Tymur771/bank-transactions-site/cap-box/factory/MFC-box-RevN_drawing.pdf

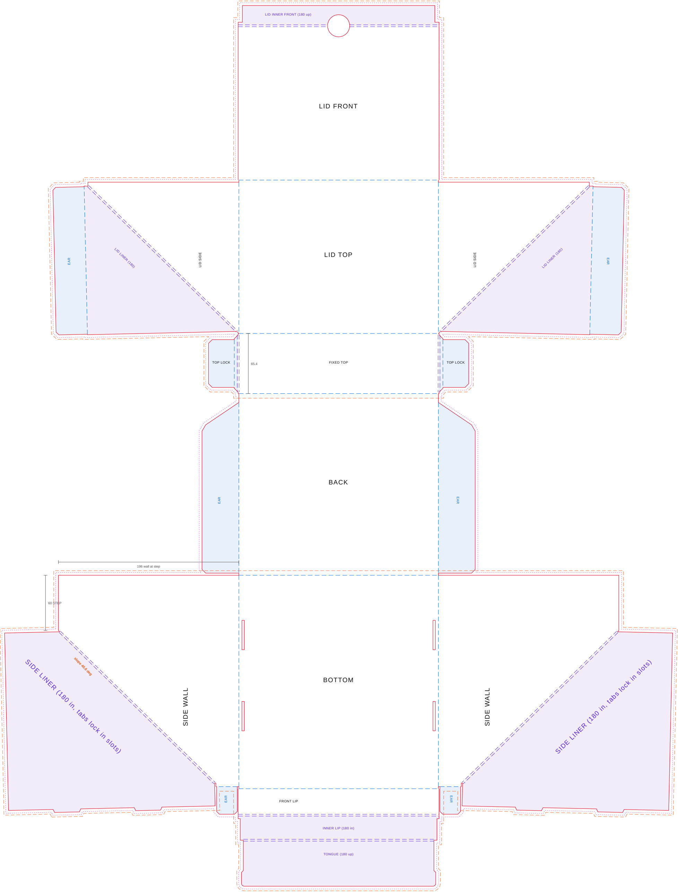
[picture p1: figure]
BOTTOM; FRONT LIP; INNER LIP (180 in); TONGUE (180 up); SID; SIDE LINER (180 in; , tabs lock in slots); SIDE LINER (180 in,; tabs lock in slots); BACK; TOP LOCK; FIXED TOP; LID TOP; LID FRONT; LID INNER FRONT (180 up); LID; LID LINER (180); 60 STEP; 196 wall at step; slope 45.6 deg

22

167.8

166.7

65.4

197.5

232.1

28.8

27.2

957.4 overall

216.7

725.5 overall

# MFC - CAP BOX

Rev N - GLUELESS, STEP 60 mm, LID HINGE AT THE STEP END, 3-LAYER FRONT TONGUE, THUMB NOTCH

Material: E-flute litho-laminated board, caliper ~1.5 mm
Scale 1:1 - units mm - view from OUTSIDE (print side)
All creases fold away from viewer

Closed box (outside approx.): 218.2 W x 233.6 D x 199 H (same as Rev H) Clear inside (between liners): 206 W x 226 D x 196 H (Rev C insert fits) Sheet size: 725.5 x 957.4
Side seam gap: 4.9 mm square to the seam (as Rev H)

CHANGE vs Rev H (orange dashed outline):
10. The side split no longer starts in the back top corner.
Base side wall keeps full height 196 for 60 mm from the back, then slopes 45.6 deg down to the front (front lip unchanged). The base now hides the Rev C insert (top front corner ~53 mm from the back at ~197 mm) when the lid is open.
11. Lid side ends 65.3 mm from the hinge; lid top is cut free over the step. Lid front, lid ears unchanged.
12. Side liners, lid liners and lid ears re-mirrored about the
new 180 fold lines; liner tabs land in the same 4 side slots.
13. Base front height at the seam 26.4 (was 33.6).
14. Rev J: the top is split by a crease 65.3 mm from the back (where the lid side starts). The back part is a FIXED TOP over the step; the lid hinges on that crease, so the lid side turns about its
own tip and stays on the base step when the lid opens.
15. Fixed top has 2 side lock flaps (28 mm) that drop inside the side walls over the step and hold it without glue.
16. Rev K: fixed top at full outside width (as the lid front) with a 180 hem on each side: smooth fold on the corner over the step,
the hem covers the raw top edges of the side walls; the lock
flap drops inside from the hem (hem 4.2 mm, lock 28 mm).
17. Lid front 167.8 mm (was 161.7): it stops 1 mm above the front lip, one clean line at the front; base diagonal ends behind the lip (26.4), so no open notch at the front corner.
18. Rev N: no tuck flap on the lid. The inner lip is plain (no tabs,
no window, the 2 front slots in the bottom are removed). A TONGUE hangs from its bottom edge (double crease) and folds 180 UP behind it: 207 wide up to 33 mm, then 211 wide (close fit between the lid liners = no side play of the lid), 50 mm high, ~22.8 mm above the front lip. Lid front + hem close OUTSIDE over it. Half-round thumb notch R12 on the bottom edge of the lid front (both layers).

NOTES - NO GLUE ANYWHERE (as Rev H)
1. Back and front lip fold up from BOTTOM.
2. Side-wall ears fold in; side walls go up, ears sit BEHIND the front lip. Inner lip folds 180 down over them (no tabs);
then fold the TONGUE 180 UP from the floor so it stands behind it; the insert tray (front edge) holds its bottom fold down.
3. Back ears fold in; side LINER folds 180 over the slope edge,
covers them, 2 tabs push into the bottom slots.
4. Fixed top folds over the step, its 2 lock flaps drop inside the side walls; the lid hinges on the crease at the front edge of the fixed top.
5. Lid front down, lid sides down, lid liners 180 over the slope
edge; their ears go in BEHIND the lid front.
6. Lid inner front folds 180 up and traps those ears;
on closing the lid front + hem go down OUTSIDE the base tongue.
7. Draft for white sample - printer to confirm crease and slot allowances for their board before die.
8. E-flute: run flutes parallel to the long side folds.

Rev N - glueless - generated from Rev H geometry

### LEGEND

Cut (incl. 4 lock slots in bottom, thumb notch) Crease / fold
Double crease 2 mm apart (180 folds) Bleed +3 mm for artwork
Changed vs Rev H

SIDE VIEW, CLOSED (scale 1:2) - front at left

STEP 60

insert

Rev H split
