Tymur771/bank-transactions-site/cap-box/design/MFC-design-directions.html

MFC · The Catch Cap · Rev I

# MFC BOX

Пять направлений дизайна коробки.

Все снимки сделаны на той же 3D-модели по реальной высечке Rev I и вкладышу Rev C. Печать внутри крышки показана как опция с двусторонней печатью. Дно у всех одинаковое: печать, флаг, «Designed in California» и значки.

Stone · v1.1: закрытая коробка

01

## Stone · v1.1

Ваше направление, доведённое до чистовика.

Логотип стал опорой композиции: 40 мм на переде, 110 мм тон-в-тон на крышке, крупно внутри и на задней стенке. Серо-бежевый картон, разреженный Montserrat и курсив Cormorant Garamond для тёплых строк.

- Картон#d8d1c6
- Внутри#dcd6cc
- Текст#4c4640
- Логотип#4a3a2f

ЗакрытаОткрытаВнутри крышкиСзадиДно

Stone · v1.1 — Открыта

Stone · v1.1 — Внутри крышки

Stone · v1.1 — Сзади

Stone · v1.1 — Дно

Noir: закрытая коробка

02

## Noir

Тёмная коробка, светлое нутро.

Матовый эспрессо снаружи, кремовый текст и логотип. При открытии внутри песочный цвет, вкладыш светлый: кепка «подсвечена» контрастом. Большой марлин на крышке почти не виден, проявляется на свету.

- Картон#2b2623
- Внутри#cdbfa8
- Текст#ece3d4

ЗакрытаОткрытаВнутри крышкиСзадиДно

Noir — Открыта

Noir — Внутри крышки

Noir — Сзади

Noir — Дно

Coastline: закрытая коробка

03

## Coastline

Линия горизонта и «the catch».

Белый, как выцветший на солнце, картон и глубокий сланцево-синий. Перед крышки повторяет вышивку кепки: «the catch» курсивом с засечками. Тонкая линия горизонта обходит все стороны на высоте 58 мм и продолжается через диагональный шов.

- Картон#eeeae2
- Внутри#e9e4db
- Текст#2e3a45

ЗакрытаОткрытаВнутри крышкиСзадиДно

Coastline — Открыта

Coastline — Внутри крышки

Coastline — Сзади

Coastline — Дно

Big Mark: закрытая коробка

04

## Big Mark

Логотип больше коробки.

Песочный картон и марлин размером 300 мм, обрезанный краями крышки: хвост и рыба на верхе, рыбак переходит на перед. Текст только по углам. Подход модных домов: знак вместо надписи.

- Картон#cbbda4
- Внутри#ece4d6
- Текст#4b4034

ЗакрытаОткрытаВнутри крышкиСзадиДно

Big Mark — Открыта

Big Mark — Внутри крышки

Big Mark — Сзади

Big Mark — Дно

Sun-faded: закрытая коробка

05

## Sun-faded

Закат по диагонали.

Двухцветная коробка: глиняно-терракотовая крышка и кремовая основа. Диагональный шов становится главным графическим приёмом: сбоку коробка читается как закат над водой. Внутри крышки тот же терракотовый цвет.

- Картон#efe6d6
- Крышка#b8704f
- Текст#8a4a31

ЗакрытаОткрытаВнутри крышкиСзадиДно

Sun-faded — Открыта

Sun-faded — Внутри крышки

Sun-faded — Сзади

Sun-faded — Дно

Нажмите на миниатюру, чтобы открыть её крупно. Для каждого направления есть файлы для печати (PDF, текст в кривых) и редактируемые SVG в cap-box/design/variants/.
