Tymur771/bank-transactions-site/cap-box/print/MFC-box-RevH_design-template.pdf

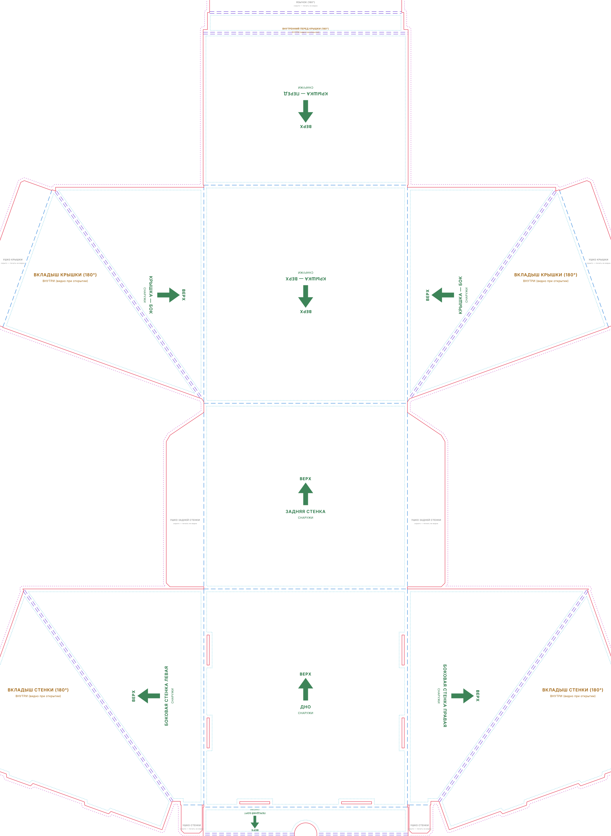
[picture p2: figure]
ВЕРХ; ДНО; СНАРУЖИ; АРУ; ВКЛАДЫШ СТЕНКИ (180°); ВНУТРИ (видно при открытии); УШКО СТЕНКИ; скрыто — печать не видна; С Н АРУ; ЗАДНЯЯ СТЕНКА; УШКО ЗАДНЕЙ СТЕНКИ; ВНУТРЕННИЙ ПЕРЕД КРЫШКИ (180°); ЯЗЫЧОК (180°); ВКЛАДЫШ КРЫШКИ (180°); УШКО КРЫШКИ

ВНУТРЕННИЙ БОРТ (180°)

ВНУТРИ (видно при открытии)

## MFC — CAP BOX · Rev H · шаблон для дизайна (вид с лицевой стороны, 1:1, мм)

Артборд 754.12 × 973.62 мм. Рисуйте в слое ARTWORK, фон тяните до пунктира BLEED (+3 мм).
Текст и логотипы — внутри голубой SAFE-зоны (3 мм от высечки и биговки). Стрелка ВЕРХ = верх на собранной коробке.
Слои CUT / CREASE / SAFE / BLEED / подсказки — технические, перед печатью скрыть (высечку даёт фабрика).
