Tymur771/bank-transactions-site/cap-box/print/MFC-box-RevI_design-template.pdf

## MFC — CAP BOX · Rev I (уступ 60 мм) · шаблон для дизайна (вид с лицевой стороны, 1:1, мм)

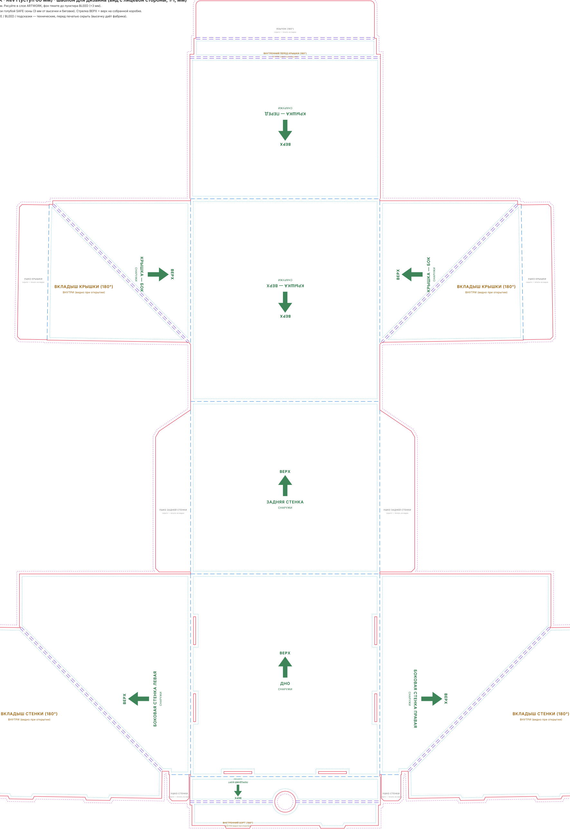
[picture p3: figure]
ВЕРХ; ДНО; СНАРУЖИ; ВНУТРЕННИЙ БОРТ (180°); ВНУТРИ (видно при открытии); АРУ; ВКЛАДЫШ СТЕНКИ (180°); УШКО СТЕНКИ; скрыто — печать не видна; С Н АРУ; ЗАДНЯЯ СТЕНКА; УШКО ЗАДНЕЙ СТЕНКИ; ВНУТРЕННИЙ ПЕРЕД КРЫШКИ (180°); ЯЗЫЧОК (180°); ВКЛАДЫШ КРЫШКИ (180°); УШКО КРЫШКИ

Артборд 757.73 × 973.6 мм. Рисуйте в слое ARTWORK, фон тяните до пунктира BLEED (+3 мм).
Текст и логотипы — внутри голубой SAFE-зоны (3 мм от высечки и биговки). Стрелка ВЕРХ = верх на собранной коробке.
Слои CUT / CREASE / SAFE / BLEED / подсказки — технические, перед печатью скрыть (высечку даёт фабрика).
