Tymur771/bank-transactions-site/cap-box/print/MFC-box-RevK_design-template.pdf

MFC — CAP BOX · Rev K (уступ 60 мм, петля на конце уступа, чистые углы) · шаблон для дизайна (1:1, мм)

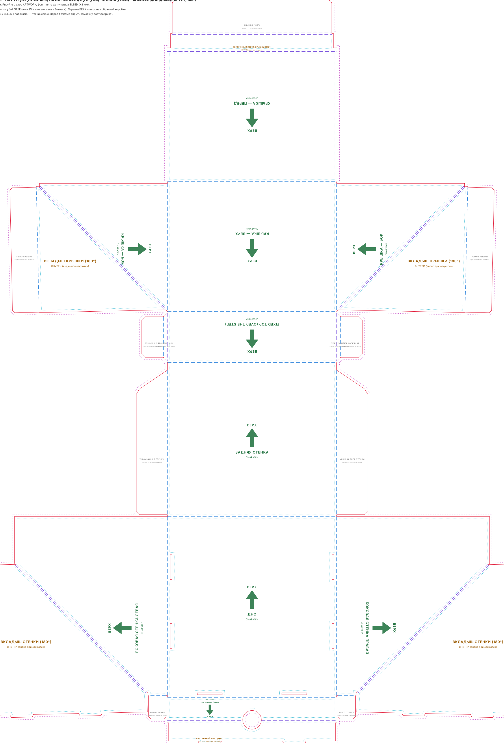
[picture p4: figure]
ВЕРХ; ДНО; СНАРУЖИ; ВНУТРЕННИЙ БОРТ (180°); ВНУТРИ (видно при открытии); АРУ; ВКЛАДЫШ СТЕНКИ (180°); УШКО СТЕНКИ; скрыто — печать не видна; С Н АРУ; ЗАДНЯЯ СТЕНКА; УШКО ЗАДНЕЙ СТЕНКИ; TOP HEM (180); TOP LOCK FLAP; ВНУТРЕННИЙ ПЕРЕД КРЫШКИ (180°); ЯЗЫЧОК (180°); ВКЛАДЫШ КРЫШКИ (180°); УШКО КРЫШКИ

Артборд 751.61 × 979.7 мм. Рисуйте в слое ARTWORK, фон тяните до пунктира BLEED (+3 мм).
Текст и логотипы — внутри голубой SAFE-зоны (3 мм от высечки и биговки). Стрелка ВЕРХ = верх на собранной коробке.
Слои CUT / CREASE / SAFE / BLEED / подсказки — технические, перед печатью скрыть (высечку даёт фабрика).
