Tymur771/bank-transactions-site/cap-box/print/MFC-box-RevL_design-template.pdf

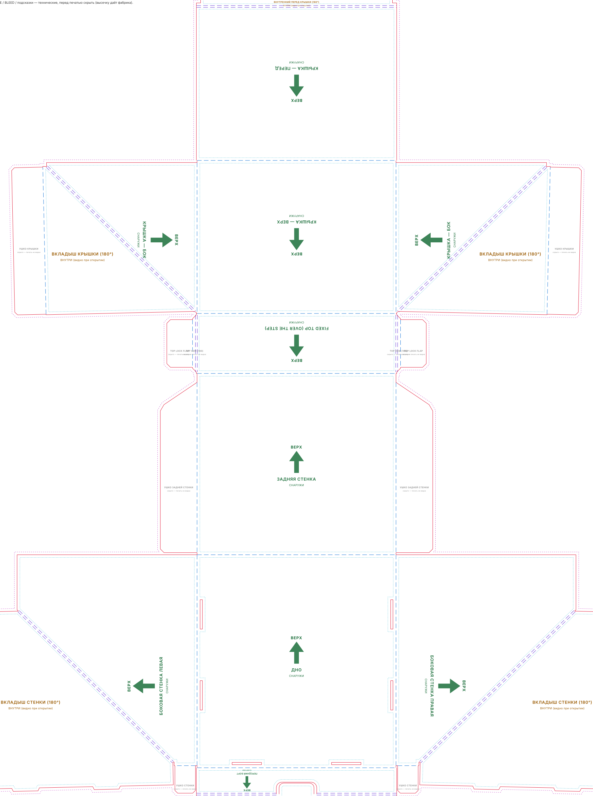
[picture p5: figure]
ВЕРХ; ДНО; СНАРУЖИ; АРУ; ВКЛАДЫШ СТЕНКИ (180°); ВНУТРИ (видно при открытии); УШКО СТЕНКИ; скрыто — печать не видна; С Н АРУ; ЗАДНЯЯ СТЕНКА; УШКО ЗАДНЕЙ СТЕНКИ; TOP HEM (180); TOP LOCK FLAP; ВНУТРЕННИЙ ПЕРЕД КРЫШКИ (180°); ВКЛАДЫШ КРЫШКИ (180°); УШКО КРЫШКИ

ВНУТРЕННИЙ БОРТ (180°)

ВНУТРИ (видно при открытии)

MFC — CAP BOX · Rev L (уступ 60 мм, петля на конце уступа, язычок на основе) · шаблон для дизайна (1:1, мм)

Артборд 751.61 × 936.62 мм. Рисуйте в слое ARTWORK, фон тяните до пунктира BLEED (+3 мм).
Текст и логотипы — внутри голубой SAFE-зоны (3 мм от высечки и биговки). Стрелка ВЕРХ = верх на собранной коробке.
Слои CUT / CREASE / SAFE / BLEED / подсказки — технические, перед печатью скрыть (высечку даёт фабрика).
