Tymur771/bank-transactions-site/cap-box/print/MFC-box-RevN_design-template.pdf

MFC — CAP BOX · Rev N (уступ 60 мм, петля на конце уступа, язычок третьим слоем от внутреннего борта, вырез под палец) · шаблон для дизайна (1:1, мм)

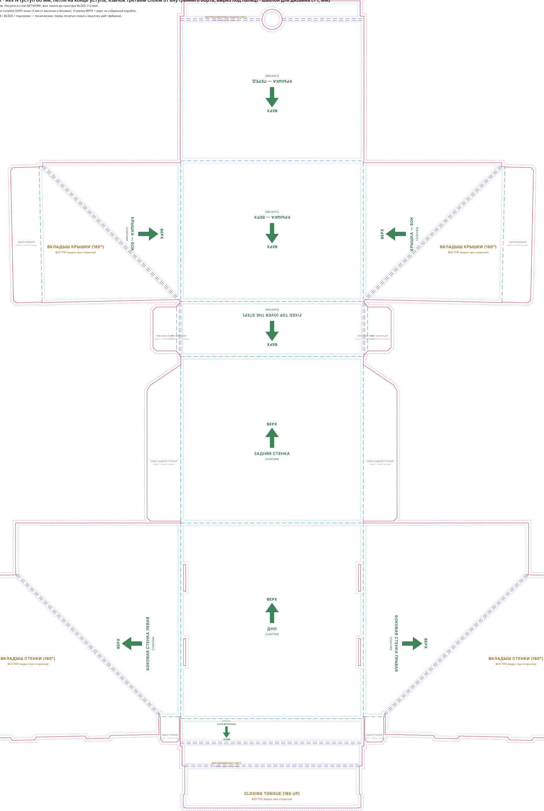
[picture p6: figure]
ВЕРХ; ДНО; СНАРУЖИ; ВНУТРЕННИЙ БОРТ (180°); ВНУТРИ (видно при открытии); CLOSING TONGUE (180 UP); АРУ; ВКЛАДЫШ СТЕНКИ (180°); УШКО СТЕНКИ; скрыто — печать не видна; С Н АРУ; ЗАДНЯЯ СТЕНКА; УШКО ЗАДНЕЙ СТЕНКИ; TOP HEM (180); TOP LOCK FLAP; ВНУТРЕННИЙ ПЕРЕД КРЫШКИ (180°); ВКЛАДЫШ КРЫШКИ (180°); УШКО КРЫШКИ

Артборд 751.61 × 983.37 мм. Рисуйте в слое ARTWORK, фон тяните до пунктира BLEED (+3 мм).
Текст и логотипы — внутри голубой SAFE-зоны (3 мм от высечки и биговки). Стрелка ВЕРХ = верх на собранной коробке.
Слои CUT / CREASE / SAFE / BLEED / подсказки — технические, перед печатью скрыть (высечку даёт фабрика).
