Tymur771/bank-transactions-site/cap-box/design/snapshots-v1.1/stone_bottomflat.jpg

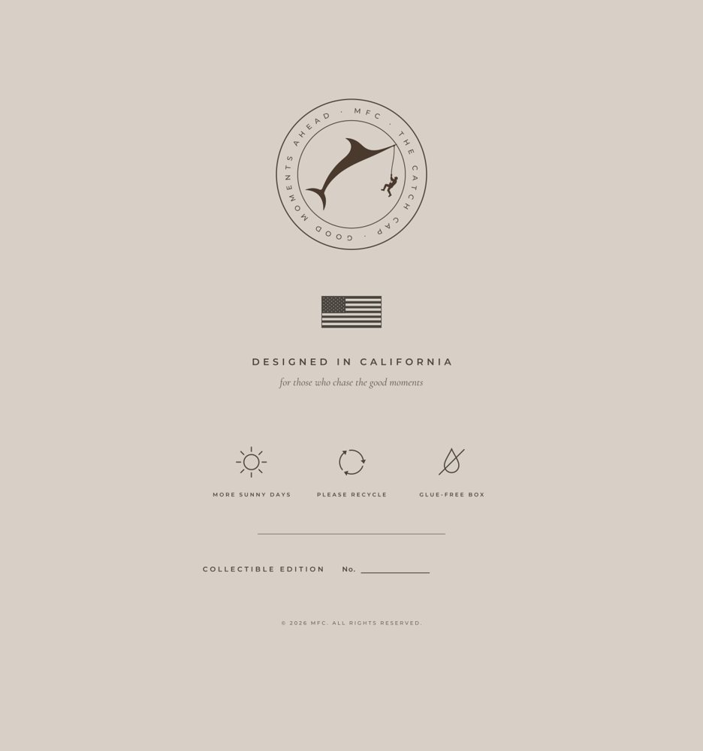
cap-box/design/snapshots-v1.1/stone_bottomflat.jpg
