Tymur771/bank-transactions-site/cap-box/design/snapshots-v1.1/stone_inside.jpg

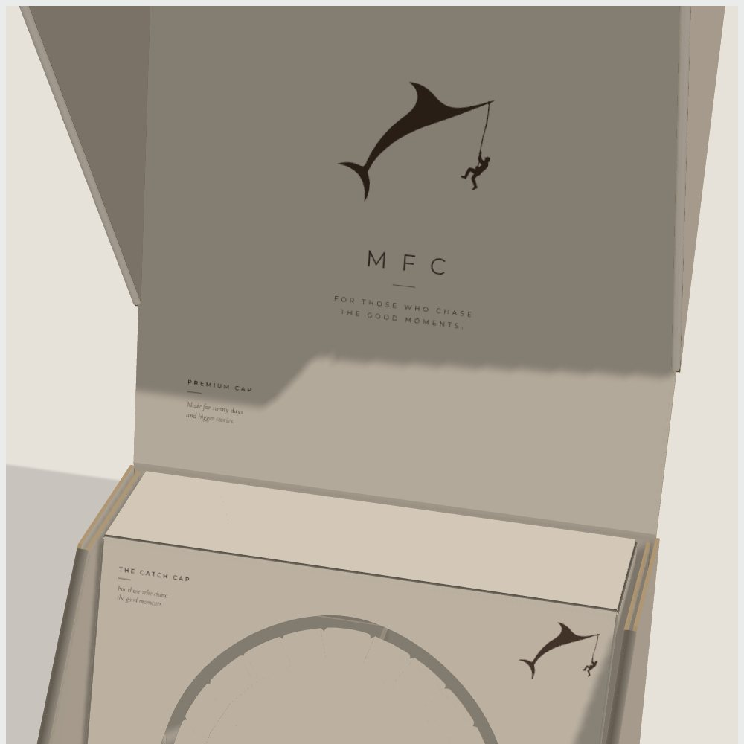
cap-box/design/snapshots-v1.1/stone_inside.jpg
