Tymur771/bank-transactions-site/cap-box/design/variants/coast/snapshots/coast_closed.jpg

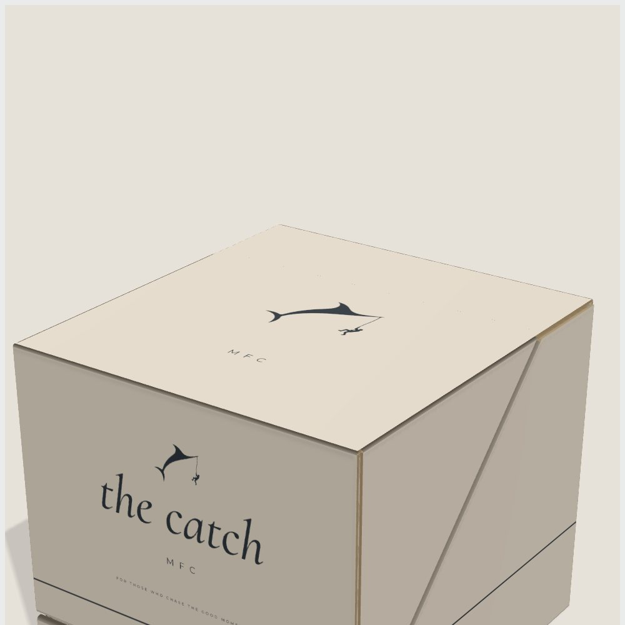
cap-box/design/variants/coast/snapshots/coast_closed.jpg
