Tymur771/bank-transactions-site/cap-box/design/variants/mark/snapshots/mark_inside.jpg

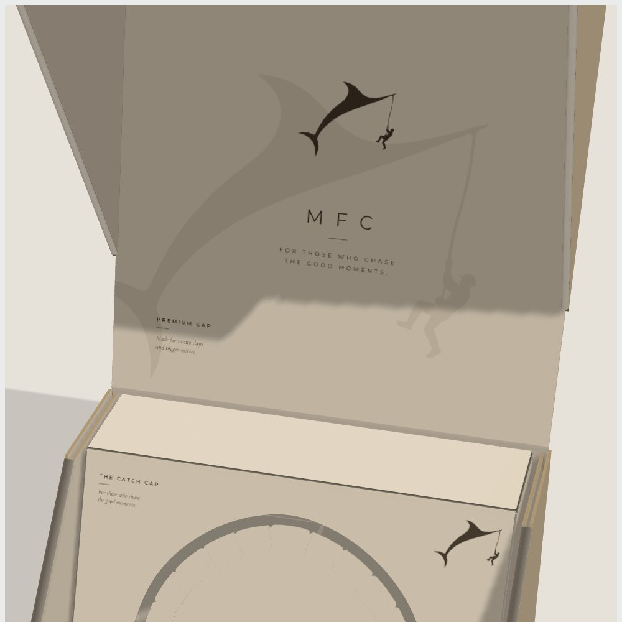
cap-box/design/variants/mark/snapshots/mark_inside.jpg
