Tymur771/bank-transactions-site/cap-box/design/variants/noir/snapshots/noir_open.jpg

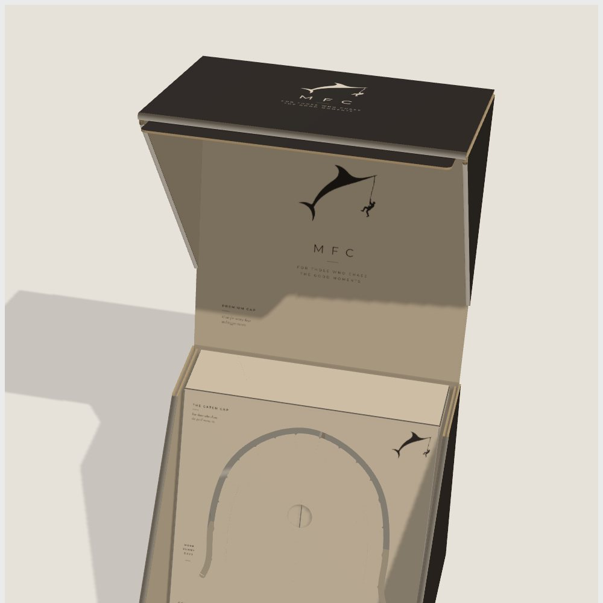
cap-box/design/variants/noir/snapshots/noir_open.jpg
