Tymur771/bank-transactions-site/cap-box/design/variants/sun/snapshots/sun_back.jpg

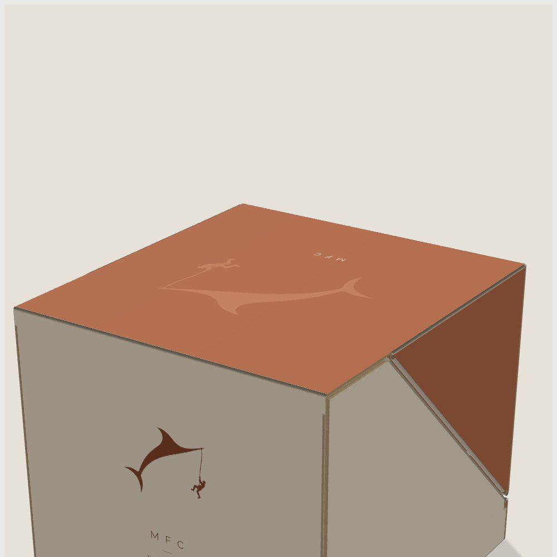
cap-box/design/variants/sun/snapshots/sun_back.jpg
