Tymur771/bank-transactions-site/cap-box/design/variants/sun/snapshots/sun_inside.jpg

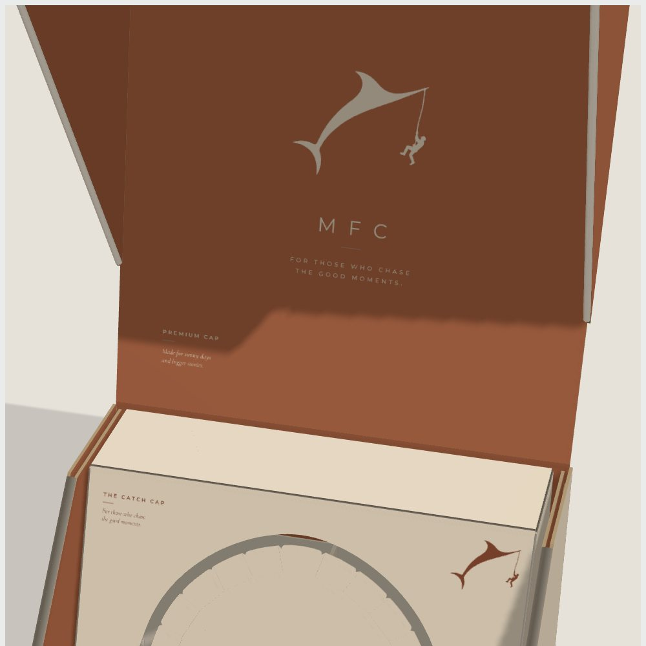
cap-box/design/variants/sun/snapshots/sun_inside.jpg
