Tymur771/bank-transactions-site/cap-box/for-michael/01_RevE_lid-closure.jpg

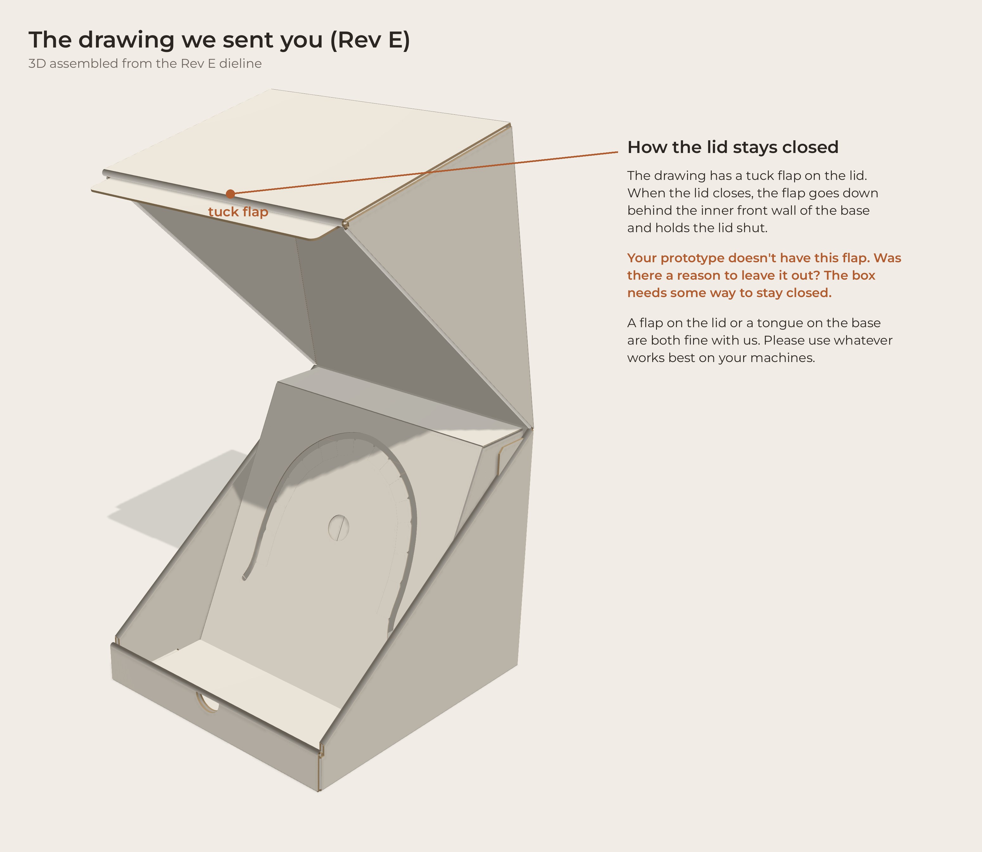
cap-box/for-michael/01_RevE_lid-closure.jpg
