Tymur771/bank-transactions-site/cap-box/for-michael/02_MFC-box_front_design.jpg

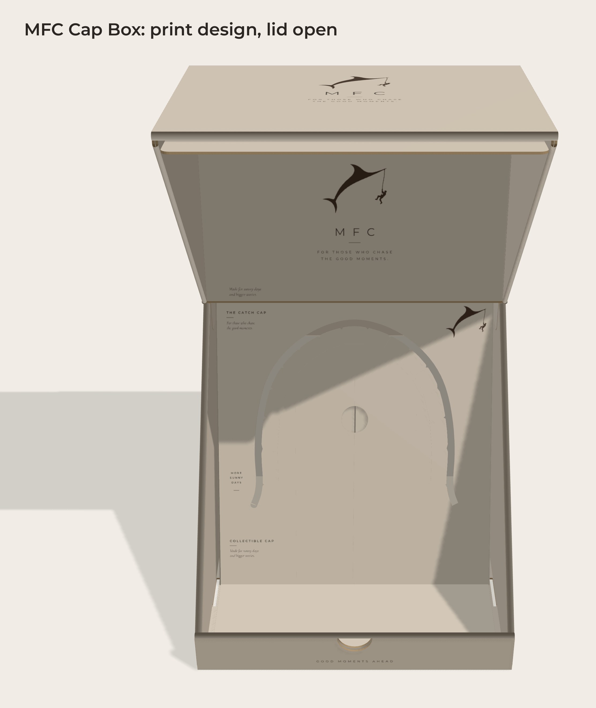
cap-box/for-michael/02_MFC-box_front_design.jpg
