Tymur771/bank-transactions-site/cap-box/for-michael/03_fold-line_now-vs-requested.jpg

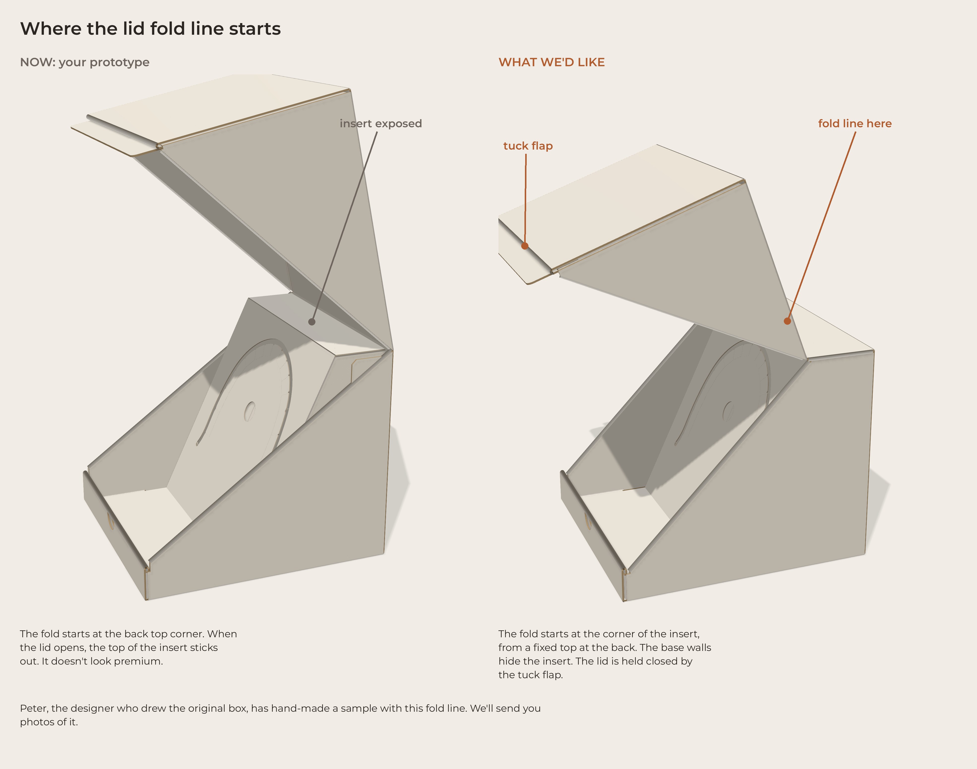
cap-box/for-michael/03_fold-line_now-vs-requested.jpg
