Tymur771/bank-transactions-site/cap-box/factory/MFC-box-RevN_dieline.dxf

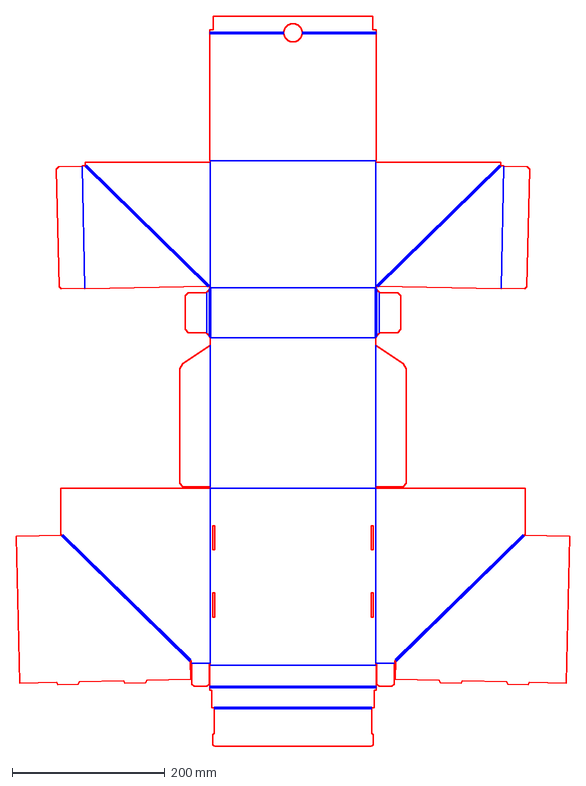
[picture p26: CAD file, 2026-11-11]
cap-box/factory/MFC-box-RevN_dieline.dxf
725.5 x 957.4 mm
