Tymur771/bank-transactions-site/cap-box/source/MFC-box-RevE-glueless-Eflute.dxf

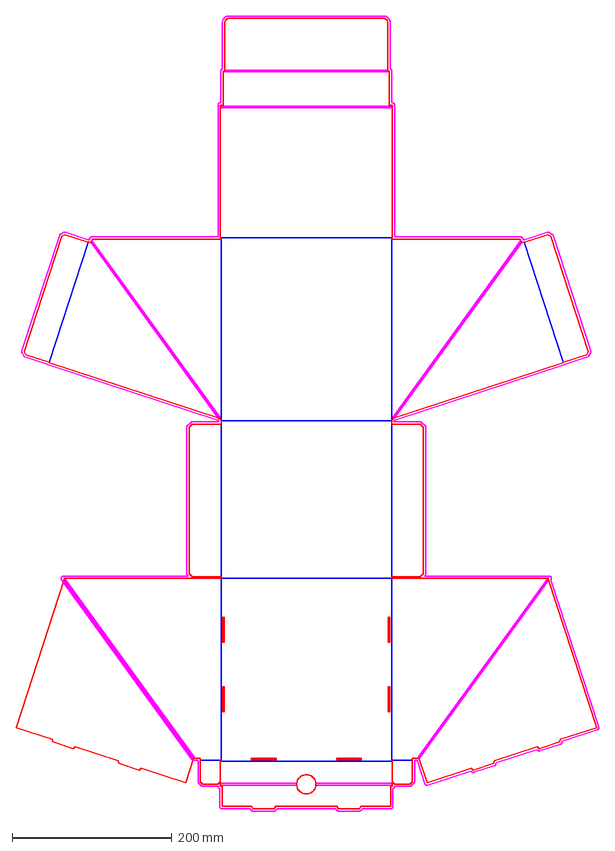
[picture p27: CAD file, 2026-11-12]
cap-box/source/MFC-box-RevE-glueless-Eflute.dxf
729.8 x 995.5 mm
