Tymur771/bank-transactions-site/cap-box/factory/MFC-insert-RevC_dieline.dxf

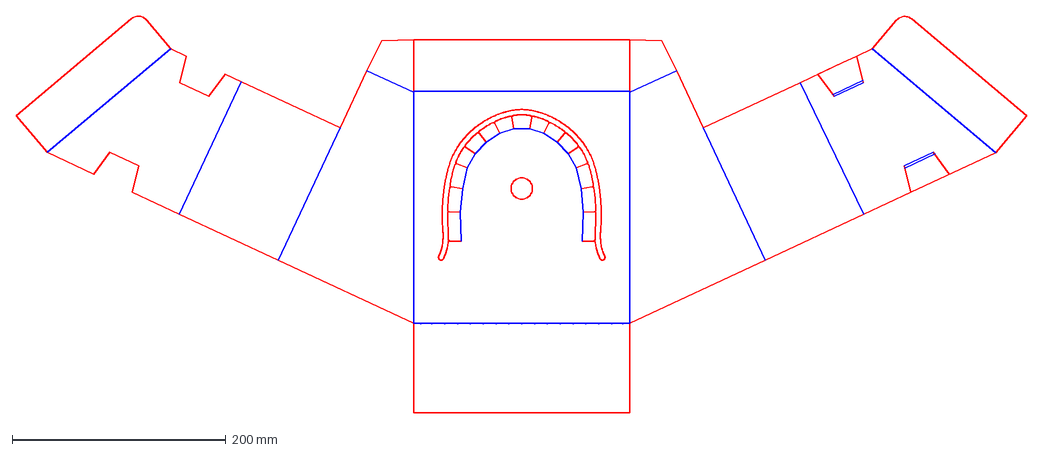
[picture p28: CAD file, 2026-11-09]
cap-box/factory/MFC-insert-RevC_dieline.dxf
945.1 x 370.8 mm
