Tymur771/bank-transactions-site/cap-box/print/MFC-box-RevI-step_dieline.pdf

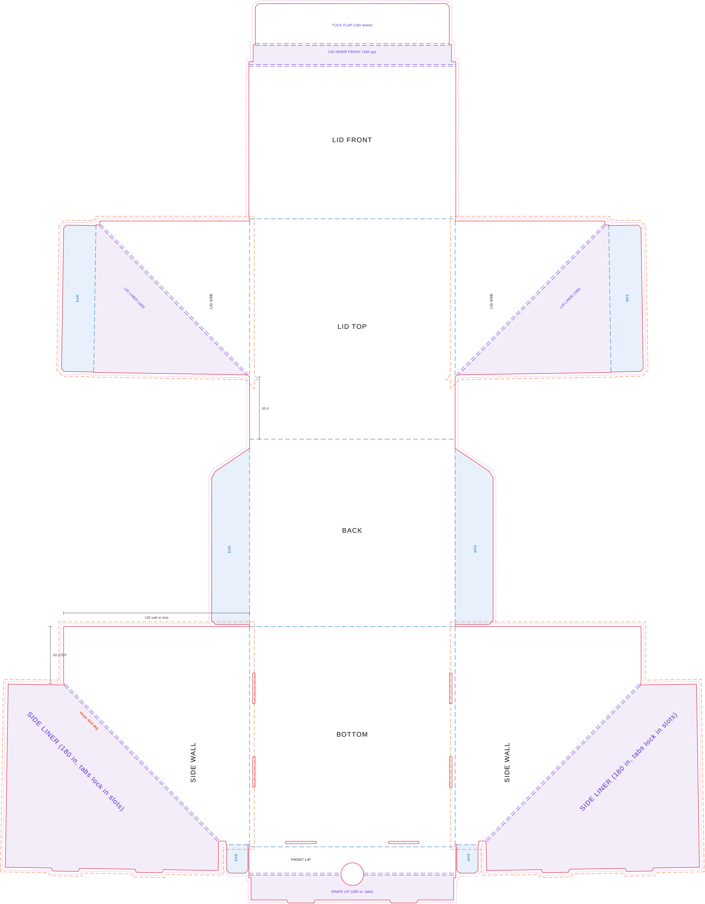
[picture p29: figure]
BOTTOM; FRONT LIP; INNER LIP (180 in, tabs); SID; SIDE LINER (180 in; , tabs lock in; slots); SIDE LINER (180 in,; tabs; lock in slots); BACK; LID TOP; LID FRONT; LID INNER FRONT (180 up); TUCK FLAP (180 down); LID; LID LINER (180); 60 STEP; 196 wall at step; slope 44.6 deg

43.1

22

161.7

232.1

197.5

232.1

28.8

30.5

947.6 overall

216.7

731.6 overall

# MFC - CAP BOX

### Rev I - GLUELESS, short tuck, STEP 60 mm at the back of the side split

Material: E-flute litho-laminated board, caliper ~1.5 mm
Scale 1:1 - units mm - view from OUTSIDE (print side)
All creases fold away from viewer

Closed box (outside approx.): 218.2 W x 233.6 D x 199 H (same as Rev H) Clear inside (between liners): 206 W x 226 D x 196 H (Rev C insert fits) Sheet size: 731.6 x 947.6
Side seam gap: 4.9 mm square to the seam (as Rev H)

CHANGE vs Rev H (orange dashed outline):
10. The side split no longer starts in the back top corner.
Base side wall keeps full height 196 for 60 mm from the back, then slopes 44.6 deg down to the front (front lip unchanged). The base now hides the Rev C insert (top front corner ~53 mm from the back at ~197 mm) when the lid is open.
11. Lid side ends 65.4 mm from the hinge; lid top is cut free over the step. Lid front, lid ears unchanged.
12. Side liners, lid liners and lid ears re-mirrored about the new 180 fold lines; liner tabs still land in the same 6 slots.
13. Base front height at the seam 32.6 (was 33.6).

NOTES - NO GLUE ANYWHERE (as Rev H)
1. Back and front lip fold up from BOTTOM.
2. Side-wall ears fold in; side walls go up, ears sit BEHIND the front lip. Inner lip folds 180 down over them, tabs into slots.
3. Back ears fold in; side LINER folds 180 over the slope edge, covers them, 2 tabs push into the bottom slots.
4. Lid hinges on the back top edge: the top is one panel.
5. Lid front down, lid sides down, lid liners 180 over the slope edge; their ears go in BEHIND the lid front.
6. Lid inner front folds 180 up and traps those ears; the tuck folds 180 down and goes in behind the inner lip.
7. Draft for white sample - printer to confirm crease and slot allowances for their board before die.
8. E-flute: run flutes parallel to the long side folds.

Rev I - glueless - generated from Rev H geometry

### LEGEND

Cut (incl. 6 lock slots in bottom) Crease / fold
Double crease 2 mm apart (180 folds) Bleed +3 mm for artwork
Changed vs Rev H

SIDE VIEW, CLOSED (scale 1:2) - front at left

STEP 60

insert

Rev H split
