Tymur771/bank-transactions-site/cap-box/factory/MFC-box-RevN_PRO-dieline-1to1.pdf

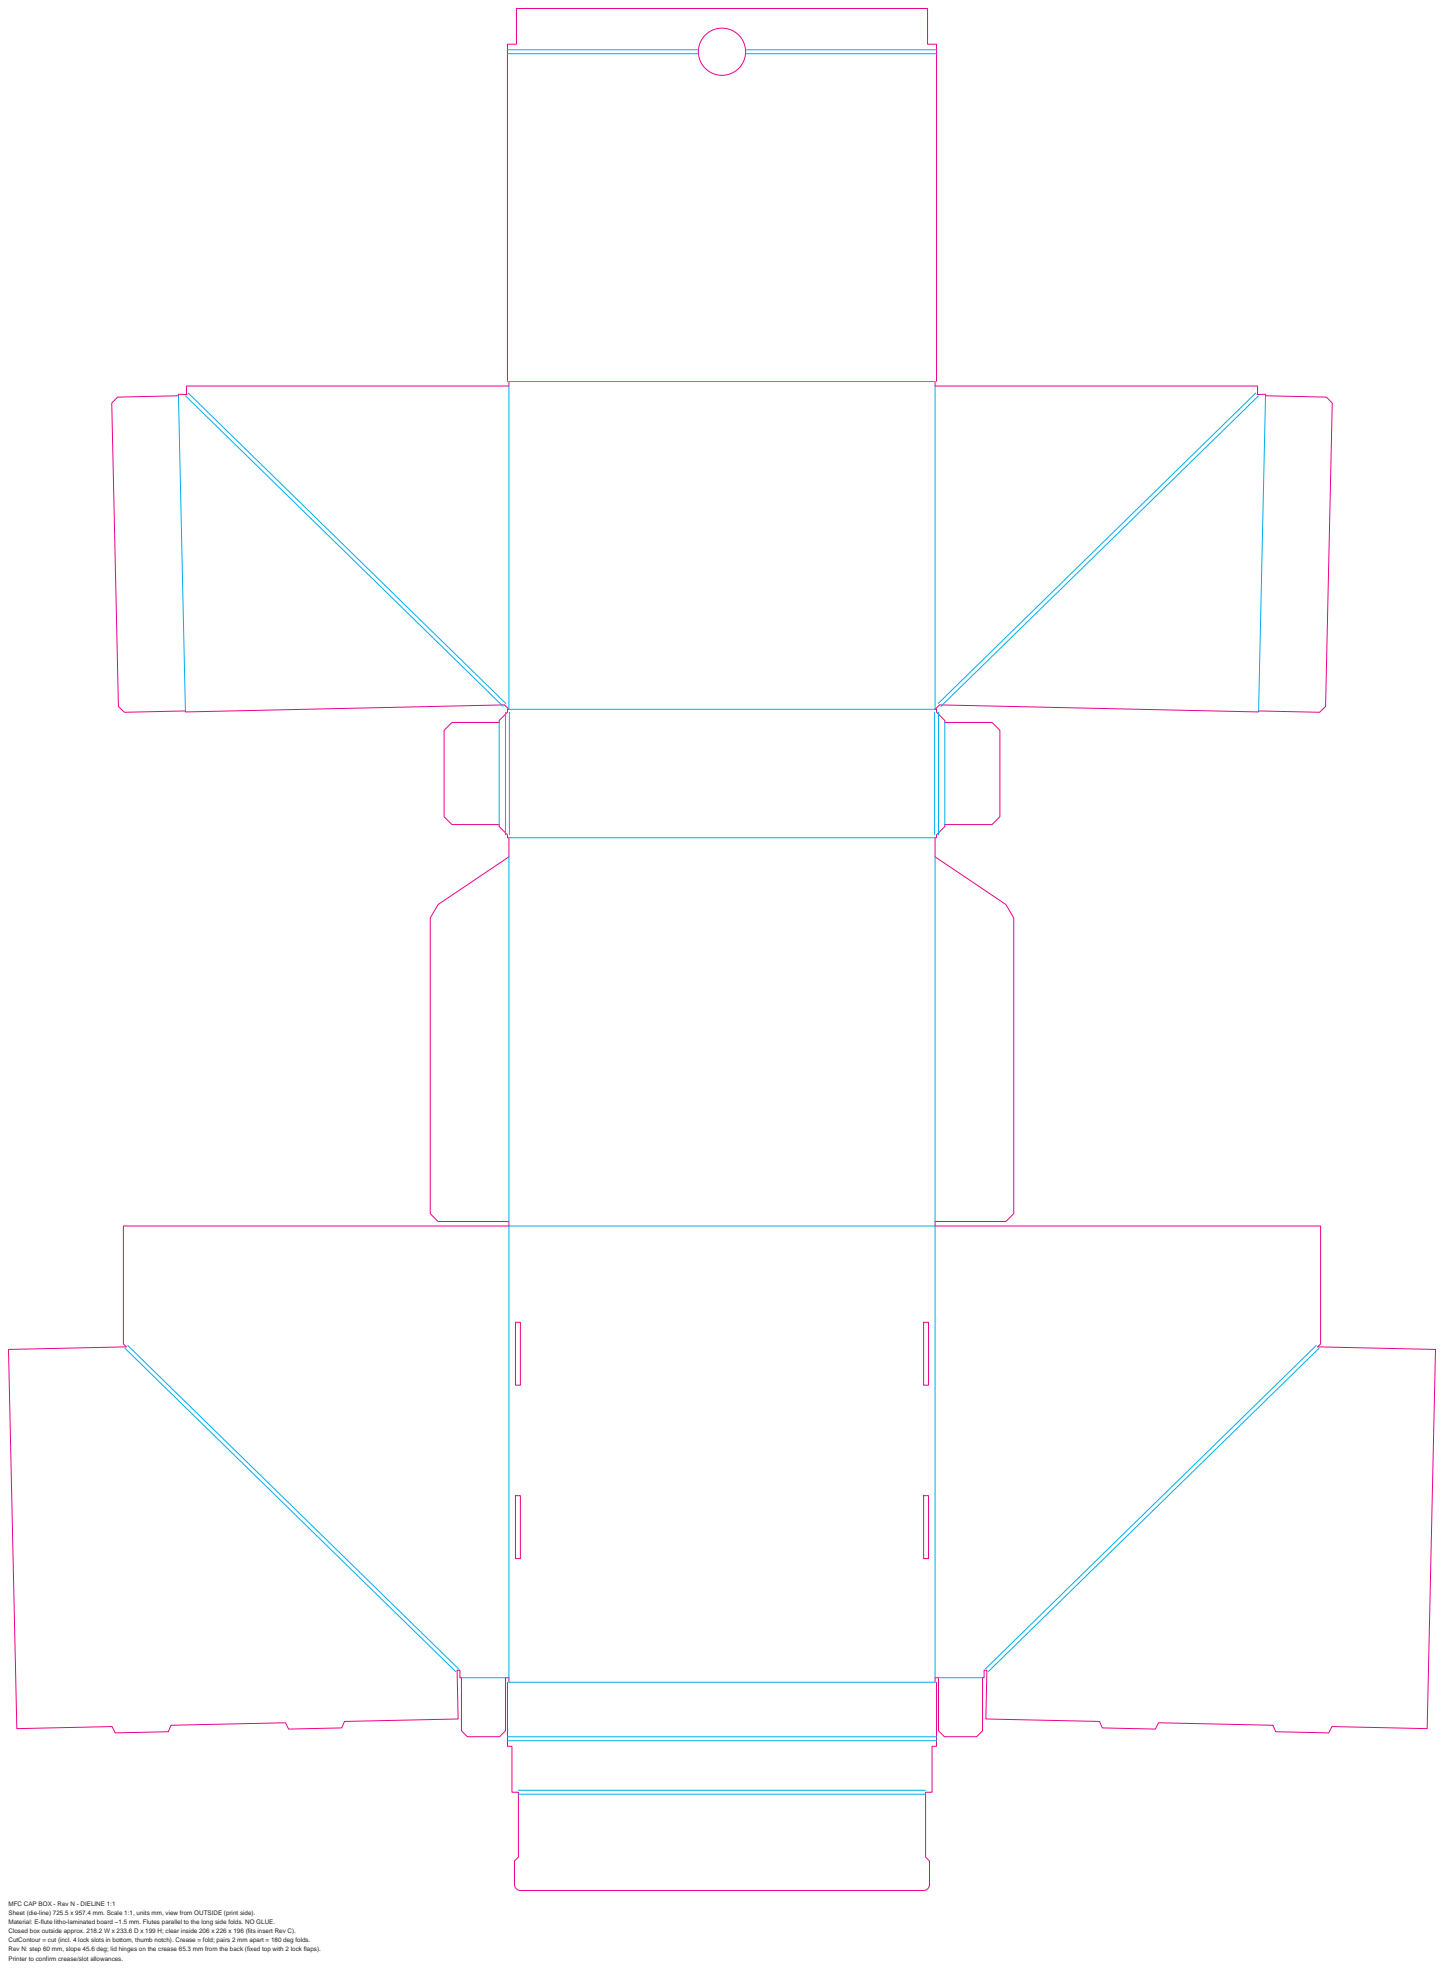
[picture p30: page 1]

MFC CAP BOX - Rev N - DIELINE 1:1
Sheet (die-line) 725.5 x 957.4 mm. Scale 1:1, units mm, view from OUTSIDE (print side).
Material: E-flute litho-laminated board ~1.5 mm. Flutes parallel to the long side folds. NO GLUE.
Closed box outside approx. 218.2 W x 233.6 D x 199 H; clear inside 206 x 226 x 196 (fits insert Rev C).
CutContour = cut (incl. 4 lock slots in bottom, thumb notch). Crease = fold; pairs 2 mm apart = 180 deg folds.
Rev N: step 60 mm, slope 45.6 deg; lid hinges on the crease 65.3 mm from the back (fixed top with 2 lock flaps).
Printer to confirm crease/slot allowances.
