Tymur771/bank-transactions-site/cap-box/factory/MFC-insert-RevC_PRO-dieline-1to1.pdf

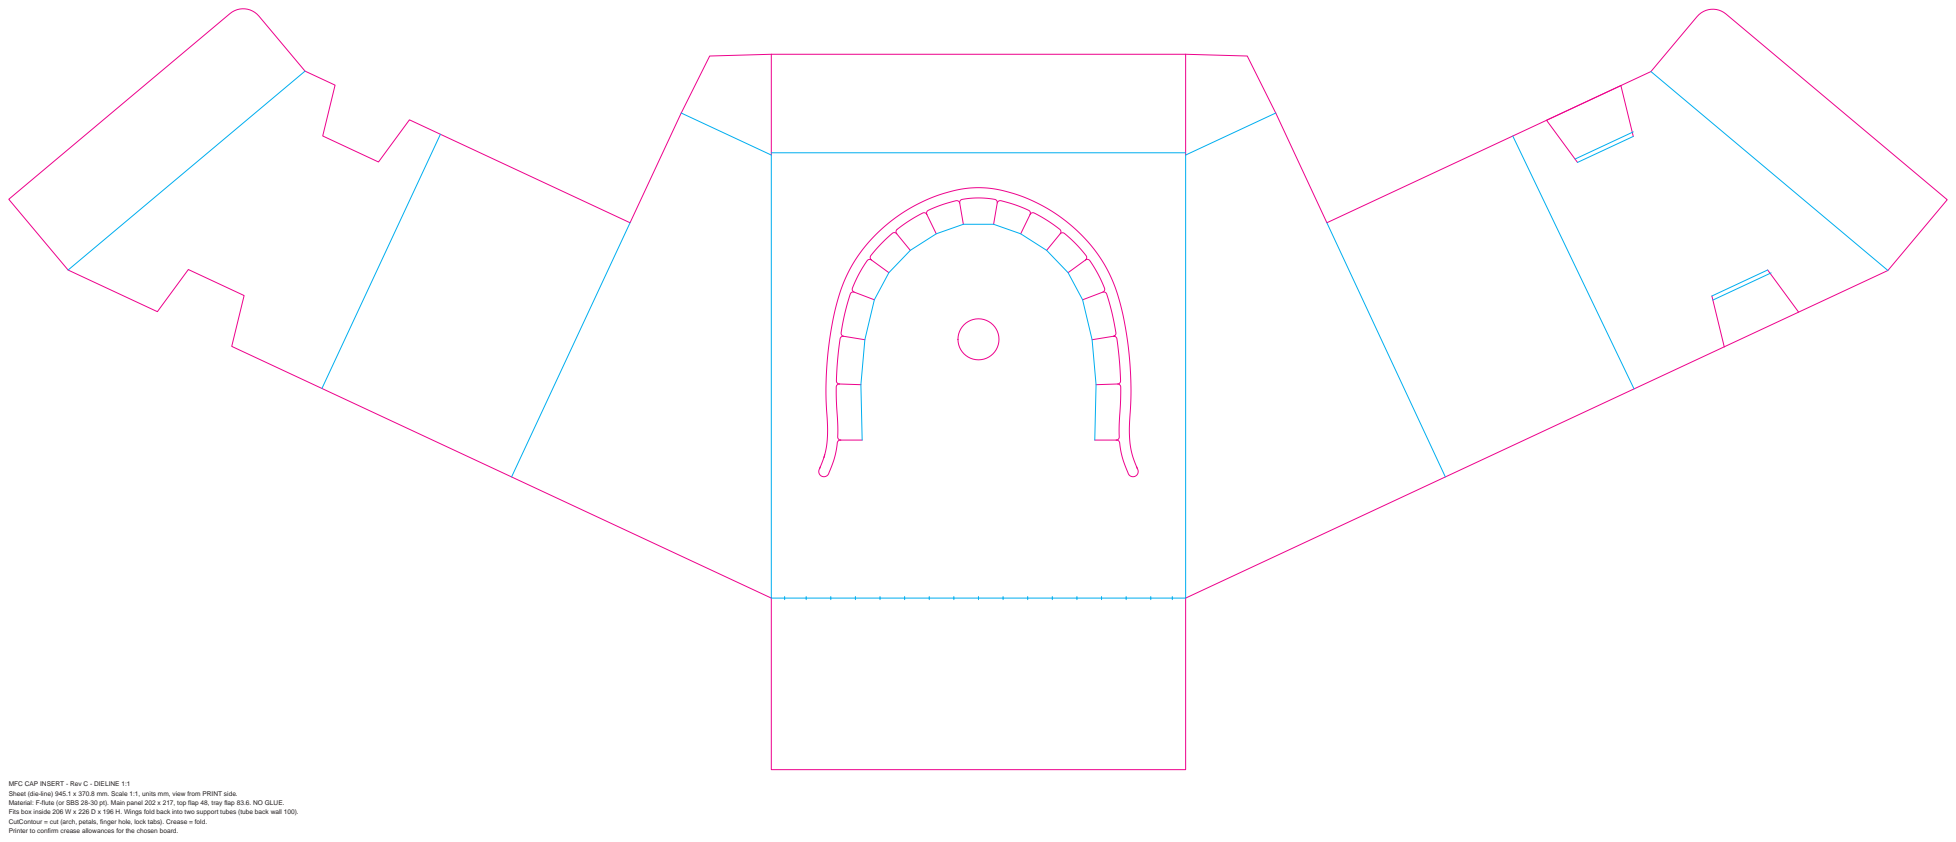
[picture p31: page 1]

MFC CAP INSERT - Rev C - DIELINE 1:1
Sheet (die-line) 945.1 x 370.8 mm. Scale 1:1, units mm, view from PRINT side.
Material: F-flute (or SBS 28-30 pt). Main panel 202 x 217, top flap 48, tray flap 83.6. NO GLUE.
Fits box inside 206 W x 226 D x 196 H. Wings fold back into two support tubes (tube back wall 100).
CutContour = cut (arch, petals, finger hole, lock tabs). Crease = fold.
Printer to confirm crease allowances for the chosen board.
