Tymur771/bank-transactions-site/cap-box/factory/MFC-insert-RevC_drawing.pdf

# MFC — CAP INSERT

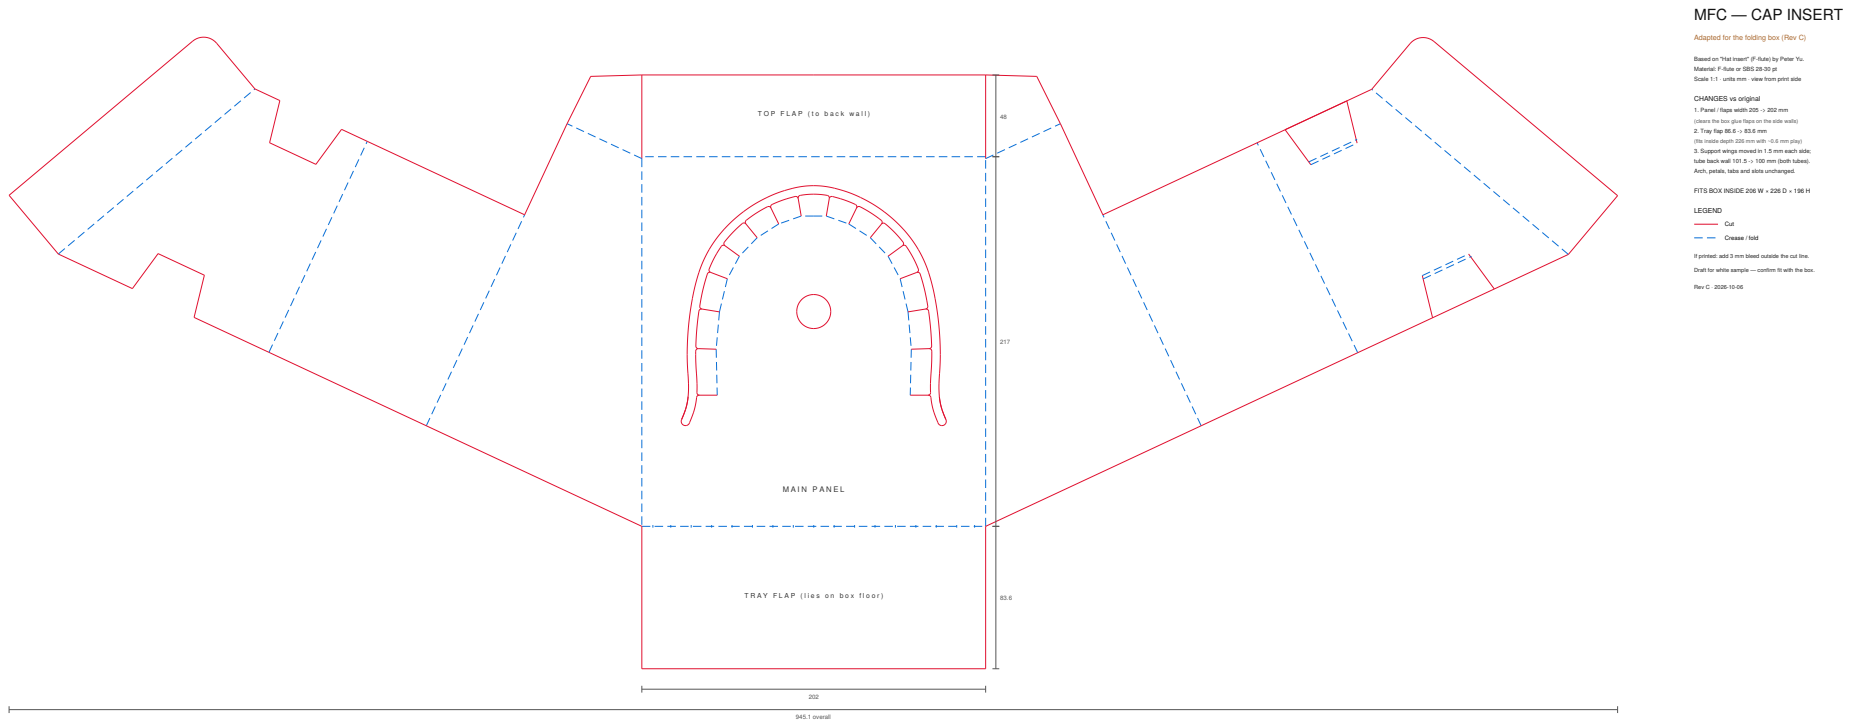
[picture p32: page 1]
945.1 overall; LEGEND; Cut; Crease / fold; Rev C · 2026-10-06

Adapted for the folding box (Rev C)

Based on "Hat insert" (F-flute) by Peter Yu.
Material: F-flute or SBS 28-30 pt
Scale 1:1 · units mm · view from print side

CHANGES vs original
1. Panel / flaps width 205 -> 202 mm
(clears the box glue flaps on the side walls)
2. Tray flap 86.6 -> 83.6 mm
(fits inside depth 226 mm with ~0.6 mm play)
3. Support wings moved in 1.5 mm each side;
tube back wall 101.5 -> 100 mm (both tubes).
Arch, petals, tabs and slots unchanged.

FITS BOX INSIDE 206 W × 226 D × 196 H

If printed: add 3 mm bleed outside the cut line.
Draft for white sample — confirm fit with the box.
