Tymur771/bank-transactions-site/cap-box/source/MFC-box-RevH-glueless-Eflute.pdf

# LID FRONT

## T U C K F L A P ( 1 8 0 d o w n )

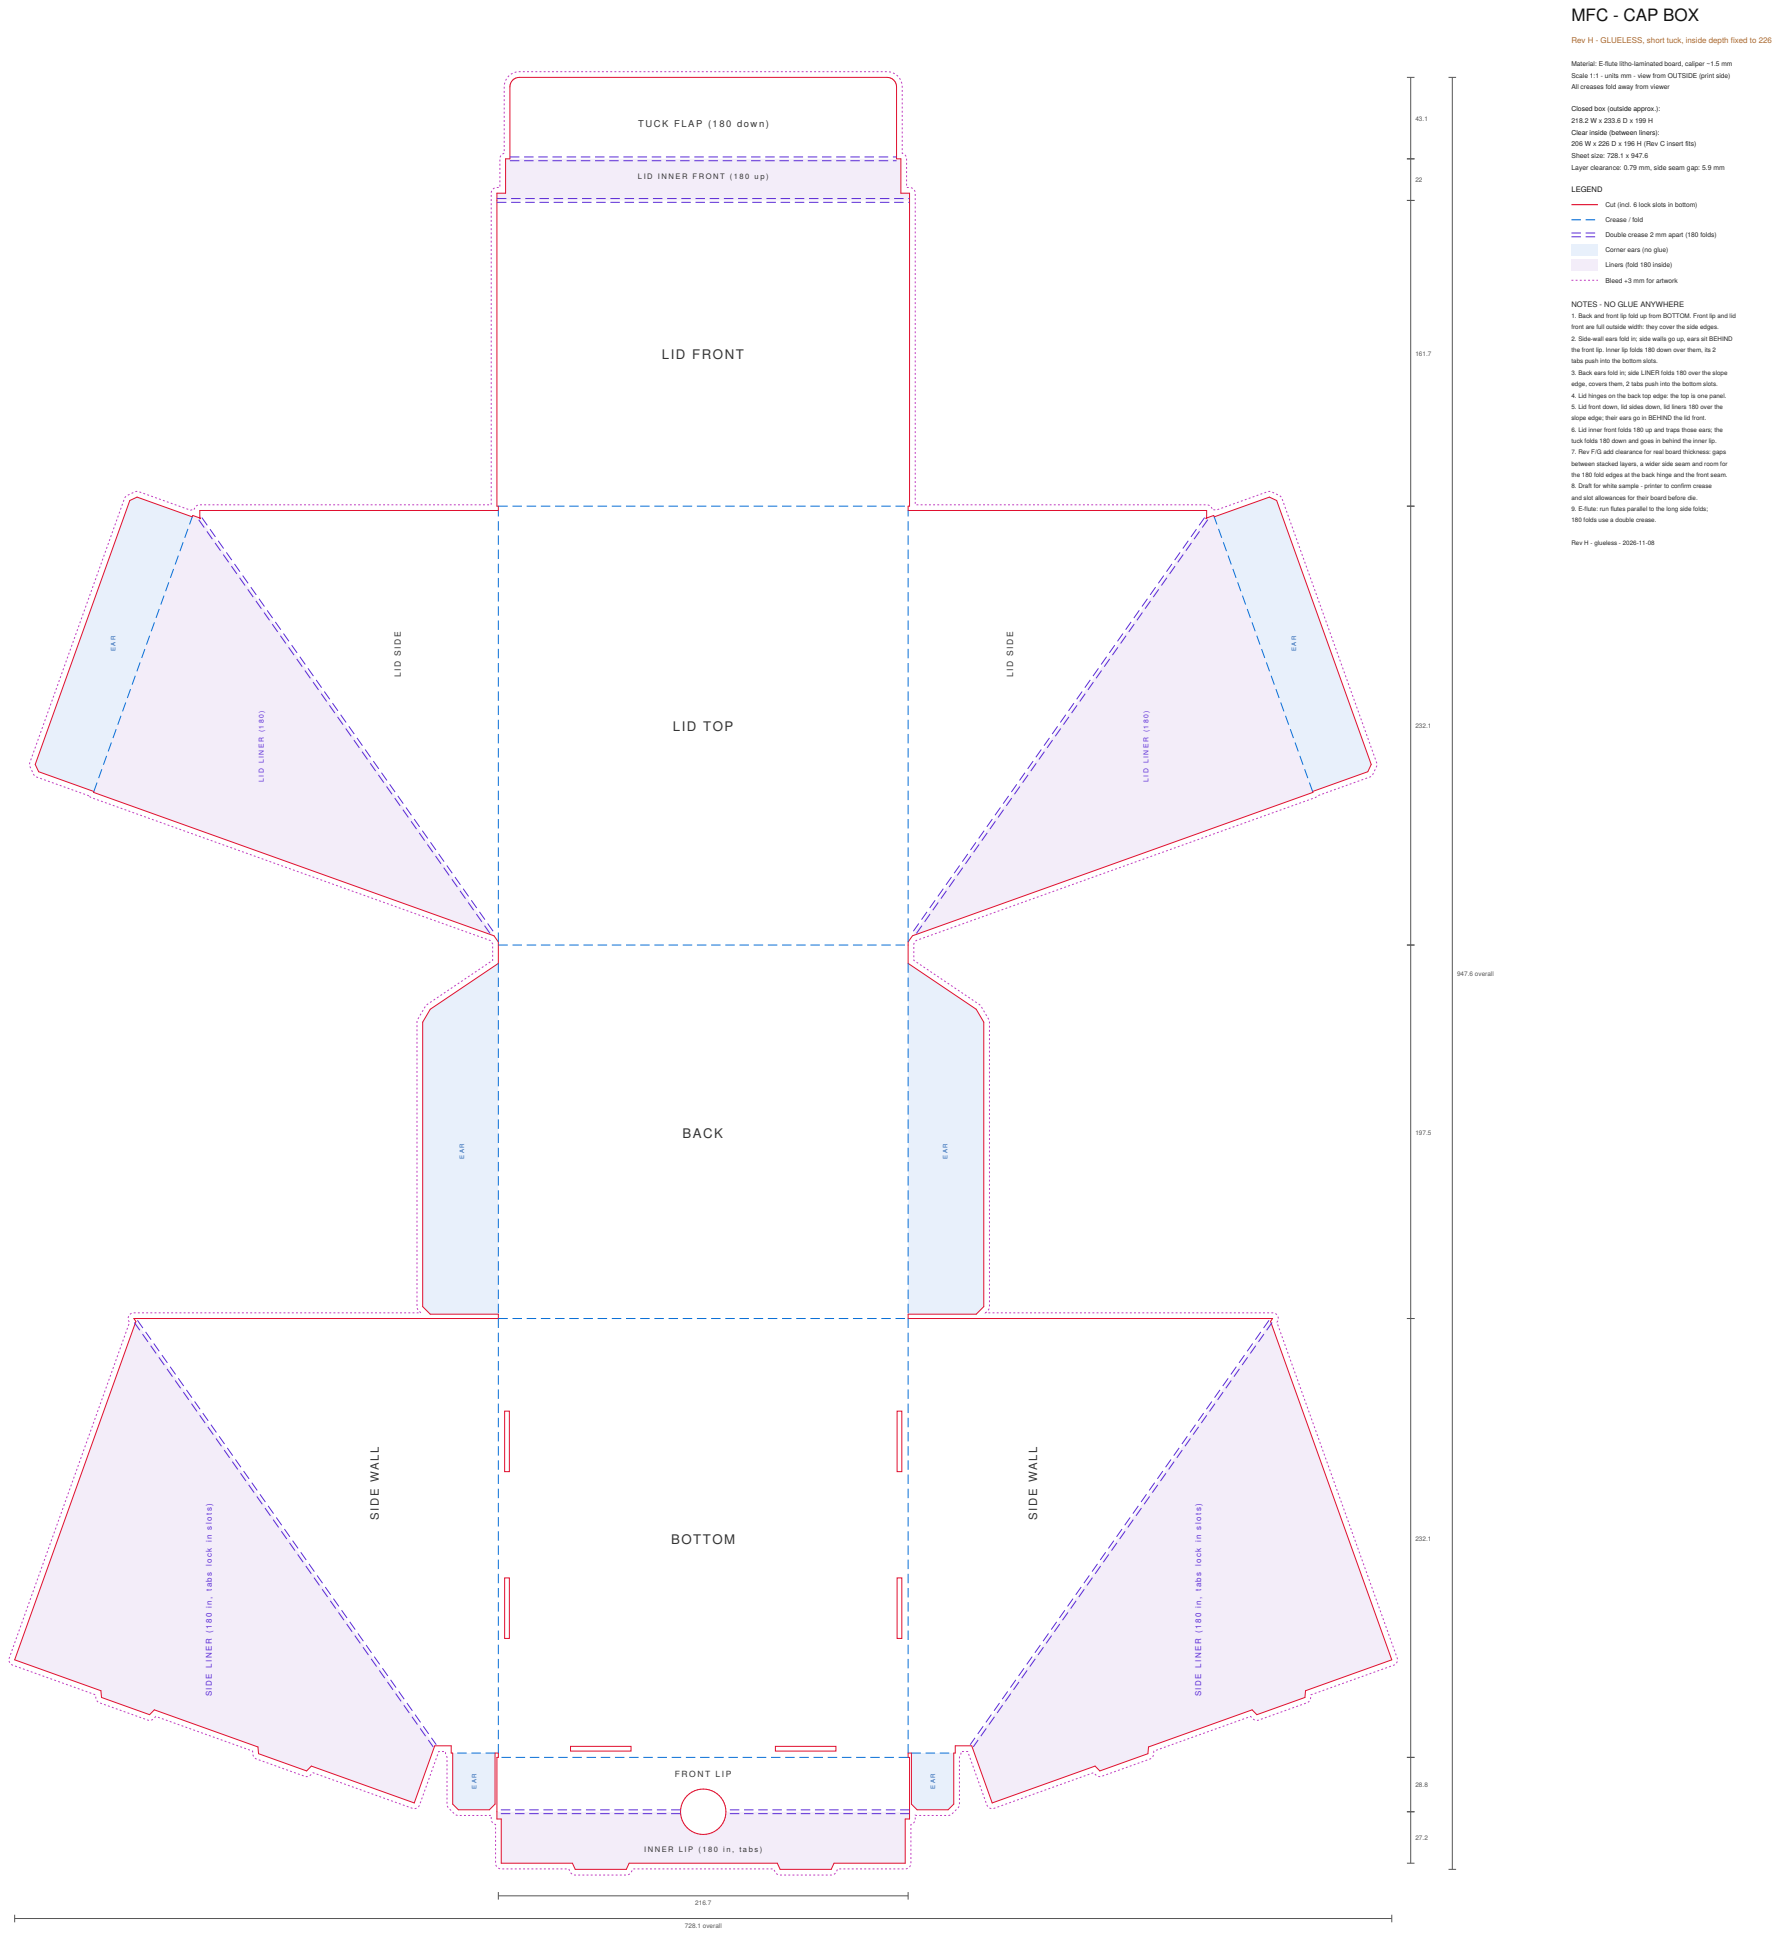
[picture p33: page 1]
BOTTOM; BACK; LID TOP; 947.6 overall; 728.1 overall; LEGEND; Rev H - glueless - 2026-11-08

MFC - CAP BOX

Rev H - GLUELESS, short tuck, inside depth fixed to 226

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

Closed box (outside approx.):
Clear inside (between liners):
206 W x 226 D x 196 H (Rev C insert fits)
Sheet size: 728.1 x 947.6
Layer clearance: 0.79 mm, side seam gap: 5.9 mm

Cut (incl. 6 lock slots in bottom)
Crease / fold
Double crease 2 mm apart (180 folds)
Corner ears (no glue)
Liners (fold 180 inside)
Bleed +3 mm for artwork

NOTES - NO GLUE ANYWHERE
1. Back and front lip fold up from BOTTOM. Front lip and lid
front are full outside width: they cover the side edges.
2. Side-wall ears fold in; side walls go up, ears sit BEHIND
the front lip. Inner lip folds 180 down over them, its 2
tabs push into the bottom slots.
3. Back ears fold in; side LINER folds 180 over the slope
edge, covers them, 2 tabs push into the bottom slots.
4. Lid hinges on the back top edge: the top is one panel.
5. Lid front down, lid sides down, lid liners 180 over the
slope edge; their ears go in BEHIND the lid front.
6. Lid inner front folds 180 up and traps those ears; the
tuck folds 180 down and goes in behind the inner lip.
7. Rev F/G add clearance for real board thickness: gaps
between stacked layers, a wider side seam and room for
the 180 fold edges at the back hinge and the front seam.
8. Draft for white sample - printer to confirm crease
and slot allowances for their board before die.
9. E-flute: run flutes parallel to the long side folds;
180 folds use a double crease.
