Tymur771/bank-transactions-site/cap-box/design/MFC-box-RevN_design-v1.1_inside_PRINT-mirrored.pdf

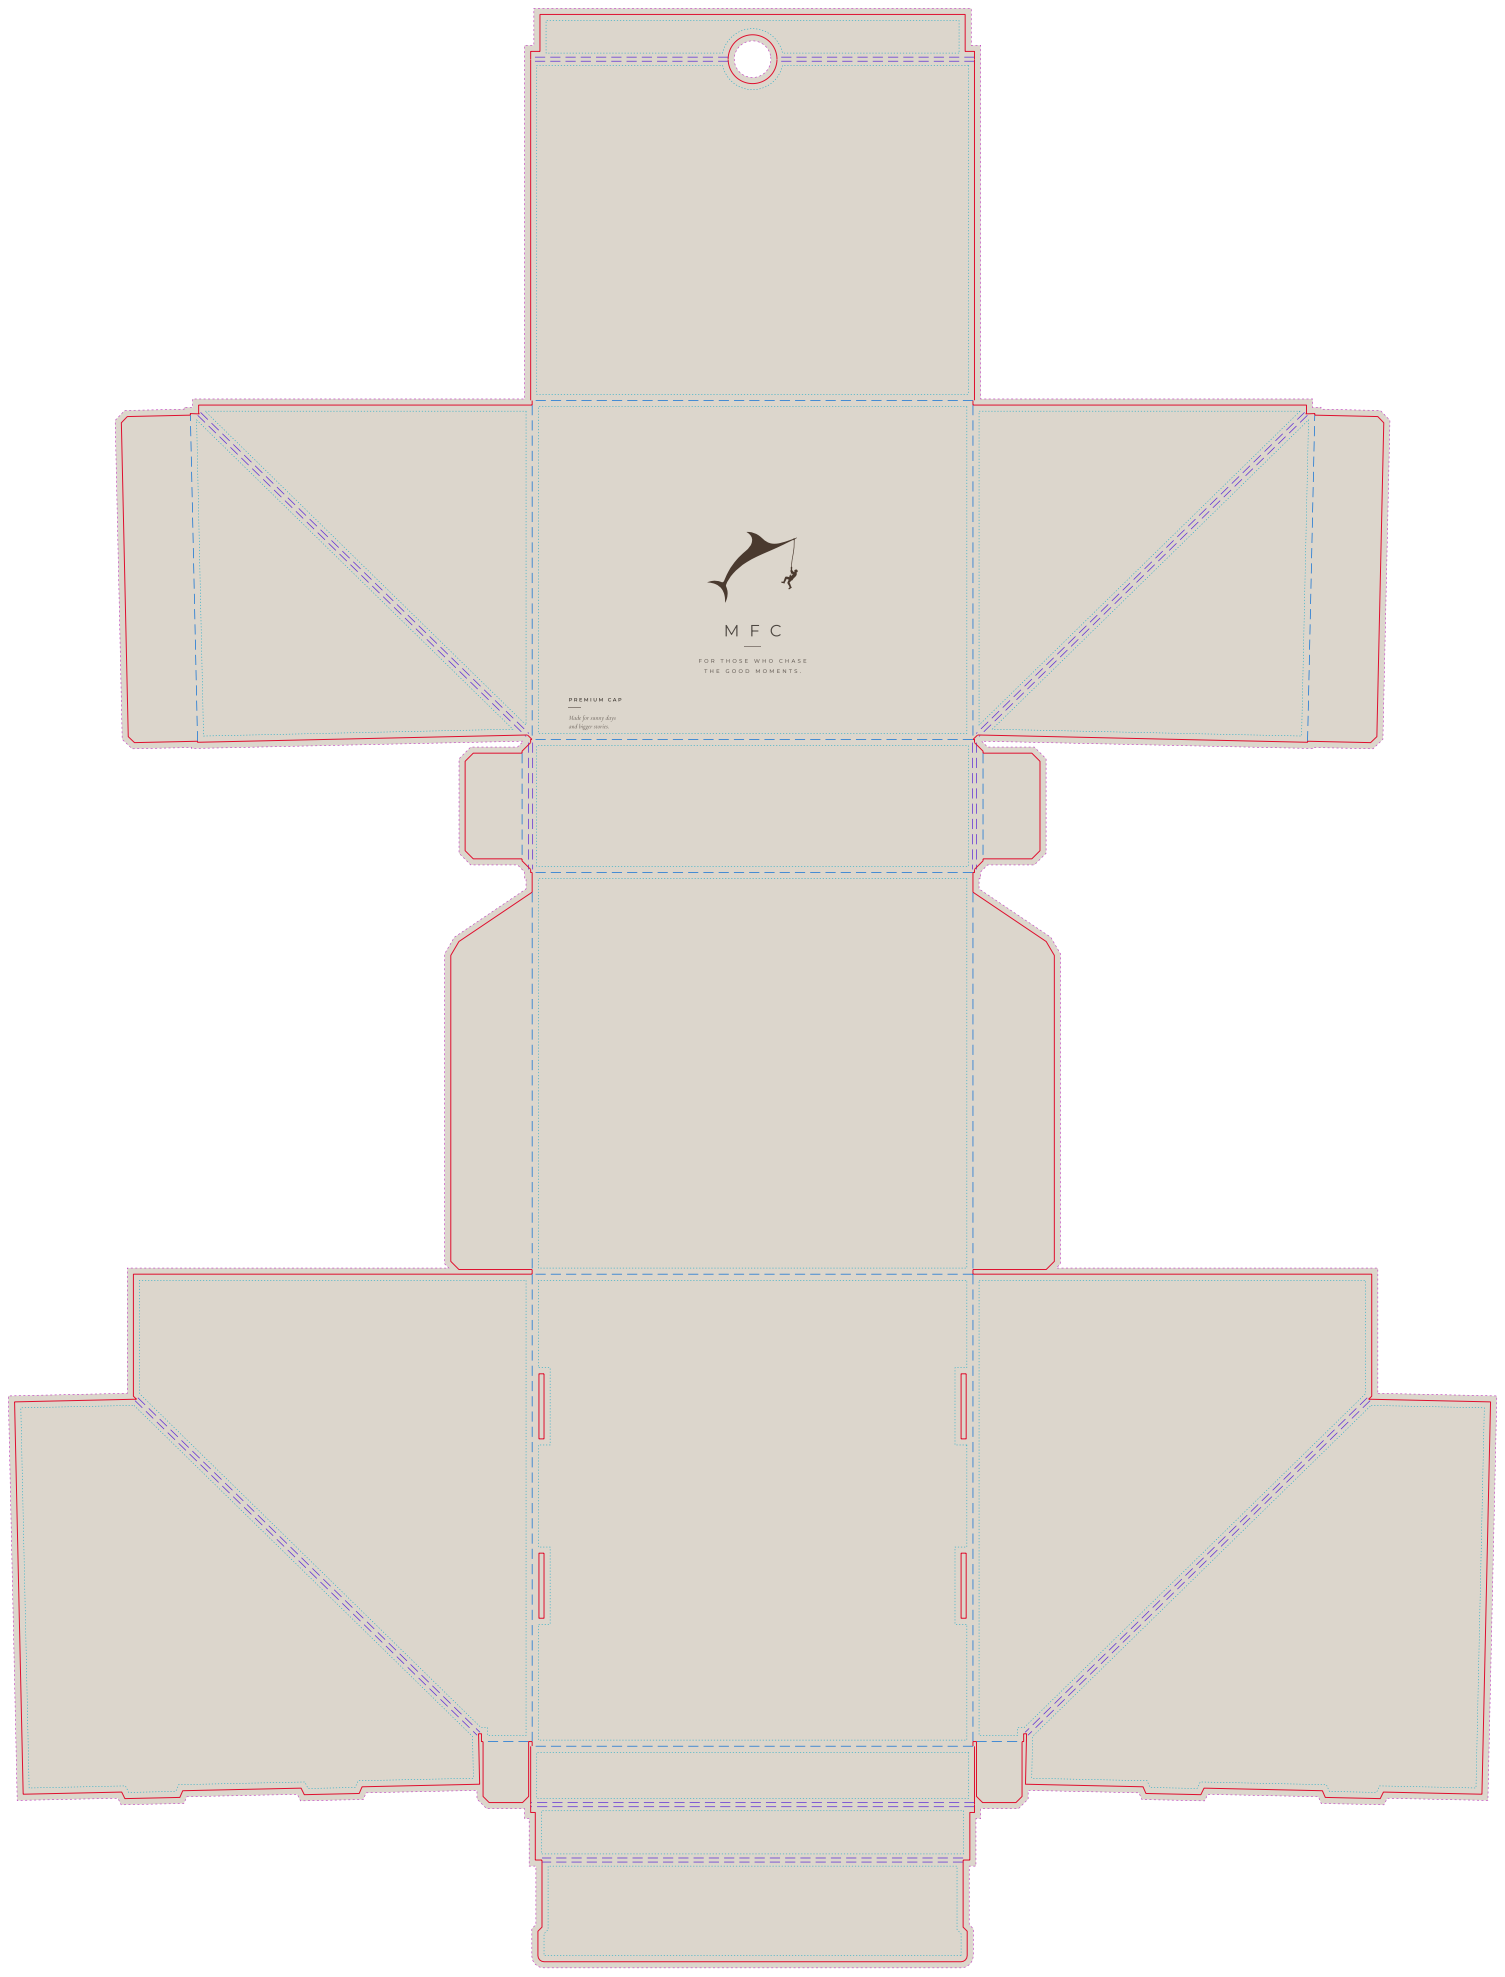
[picture p34: page 1]
