Tymur771/bank-transactions-site/cap-box/design/MFC-box-RevN_design-v1.1_outside_outlined.pdf

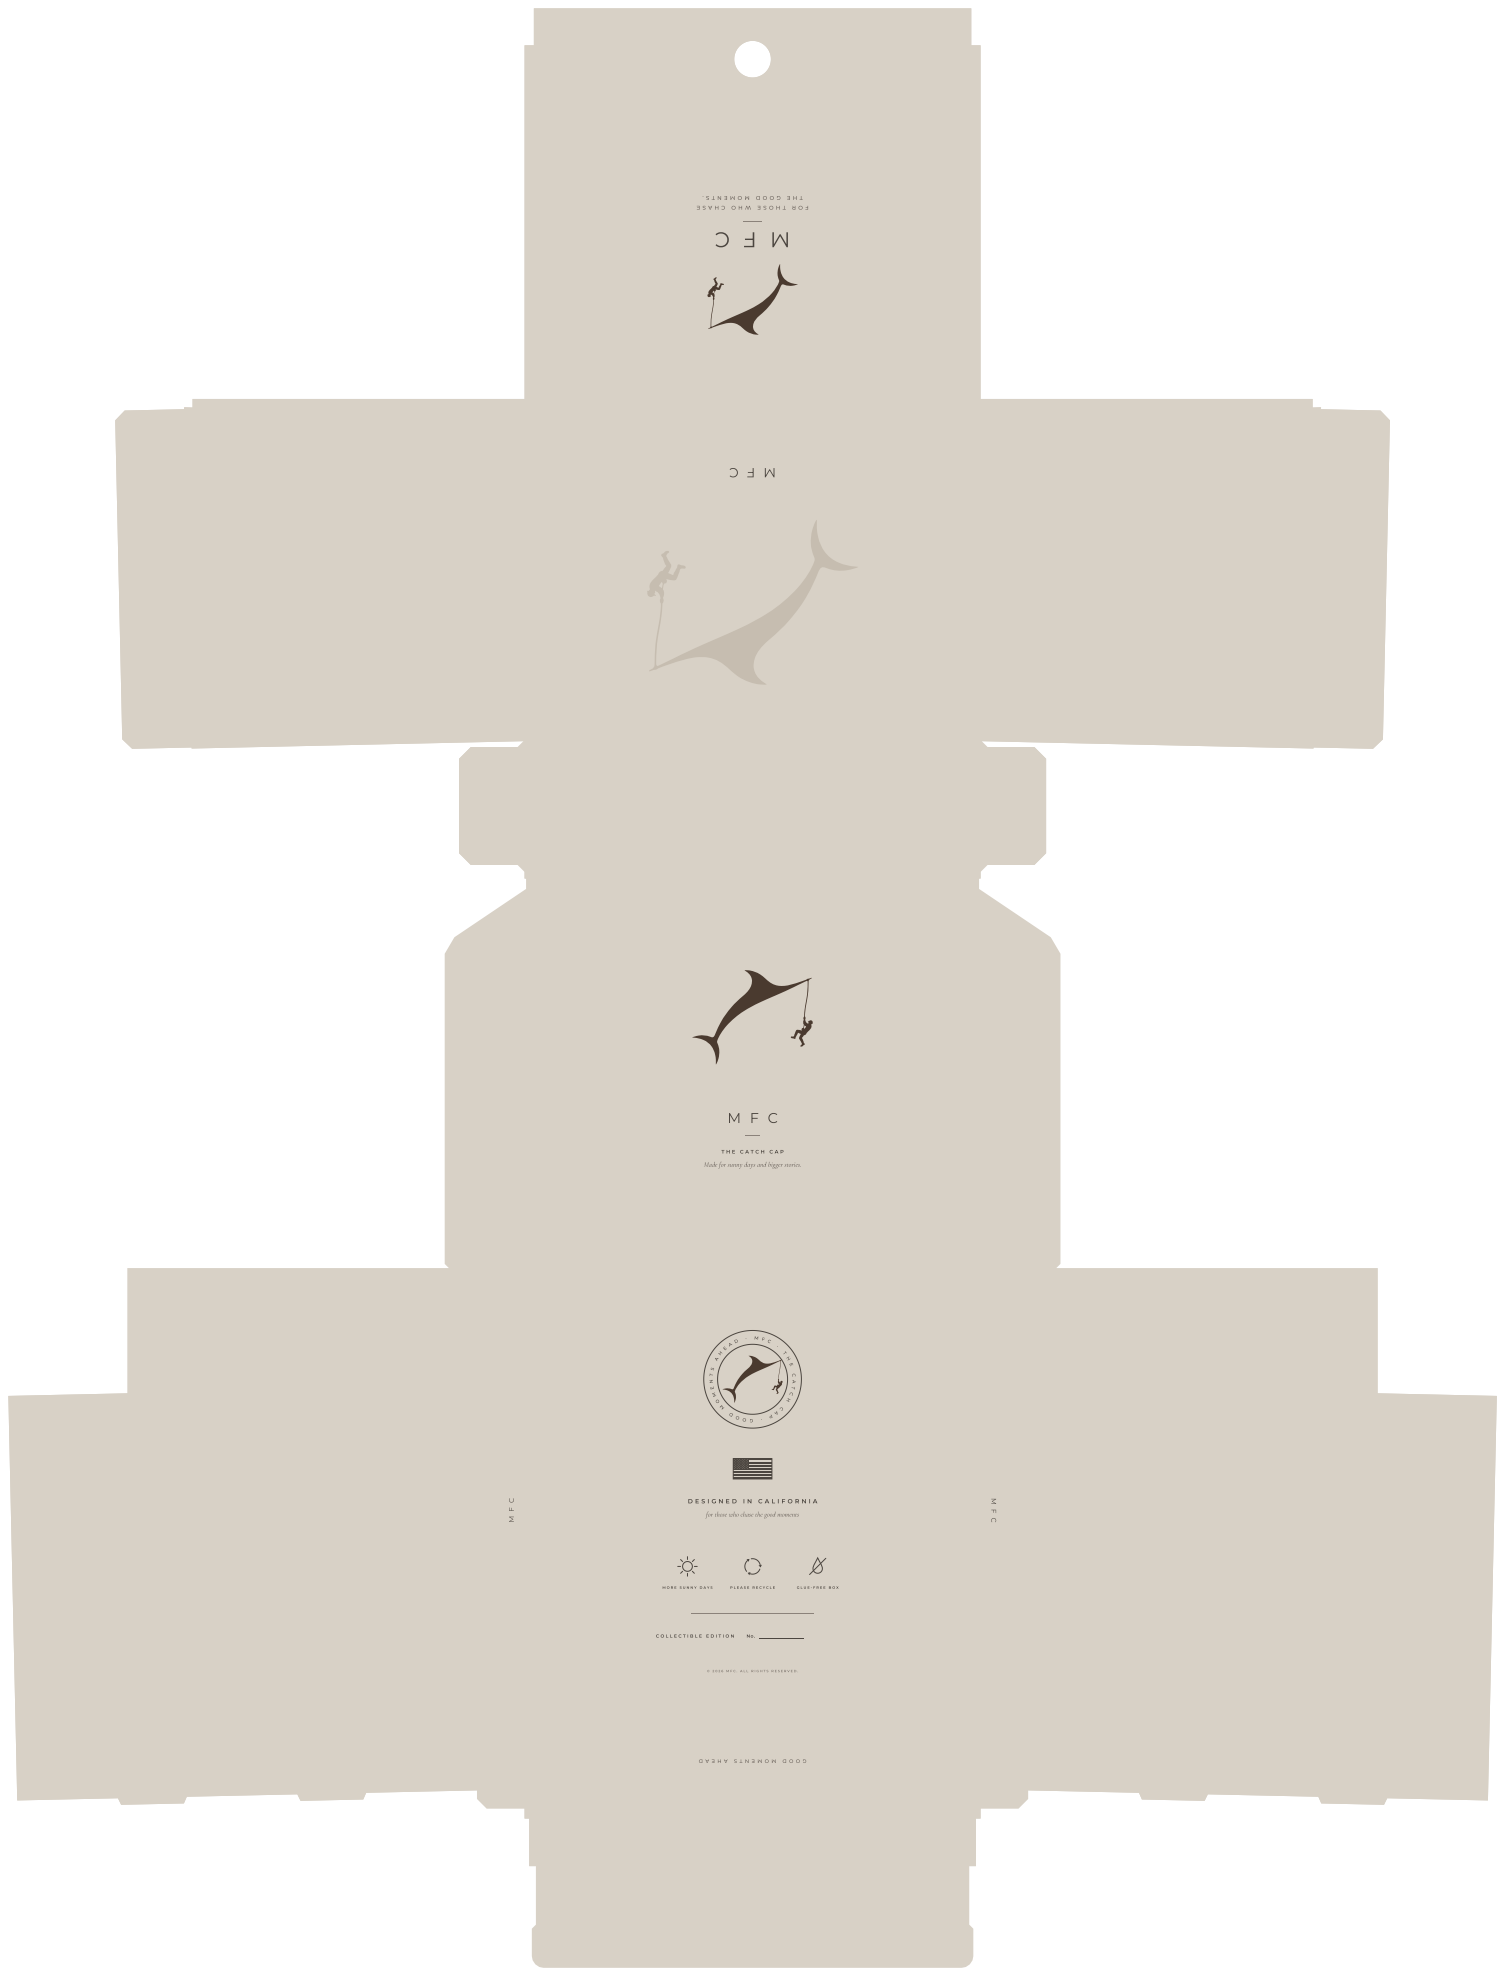
[picture p35: page 1]
