Tymur771/bank-transactions-site/cap-box/design/MFC-insert-RevC_design-v1.1_outlined.pdf

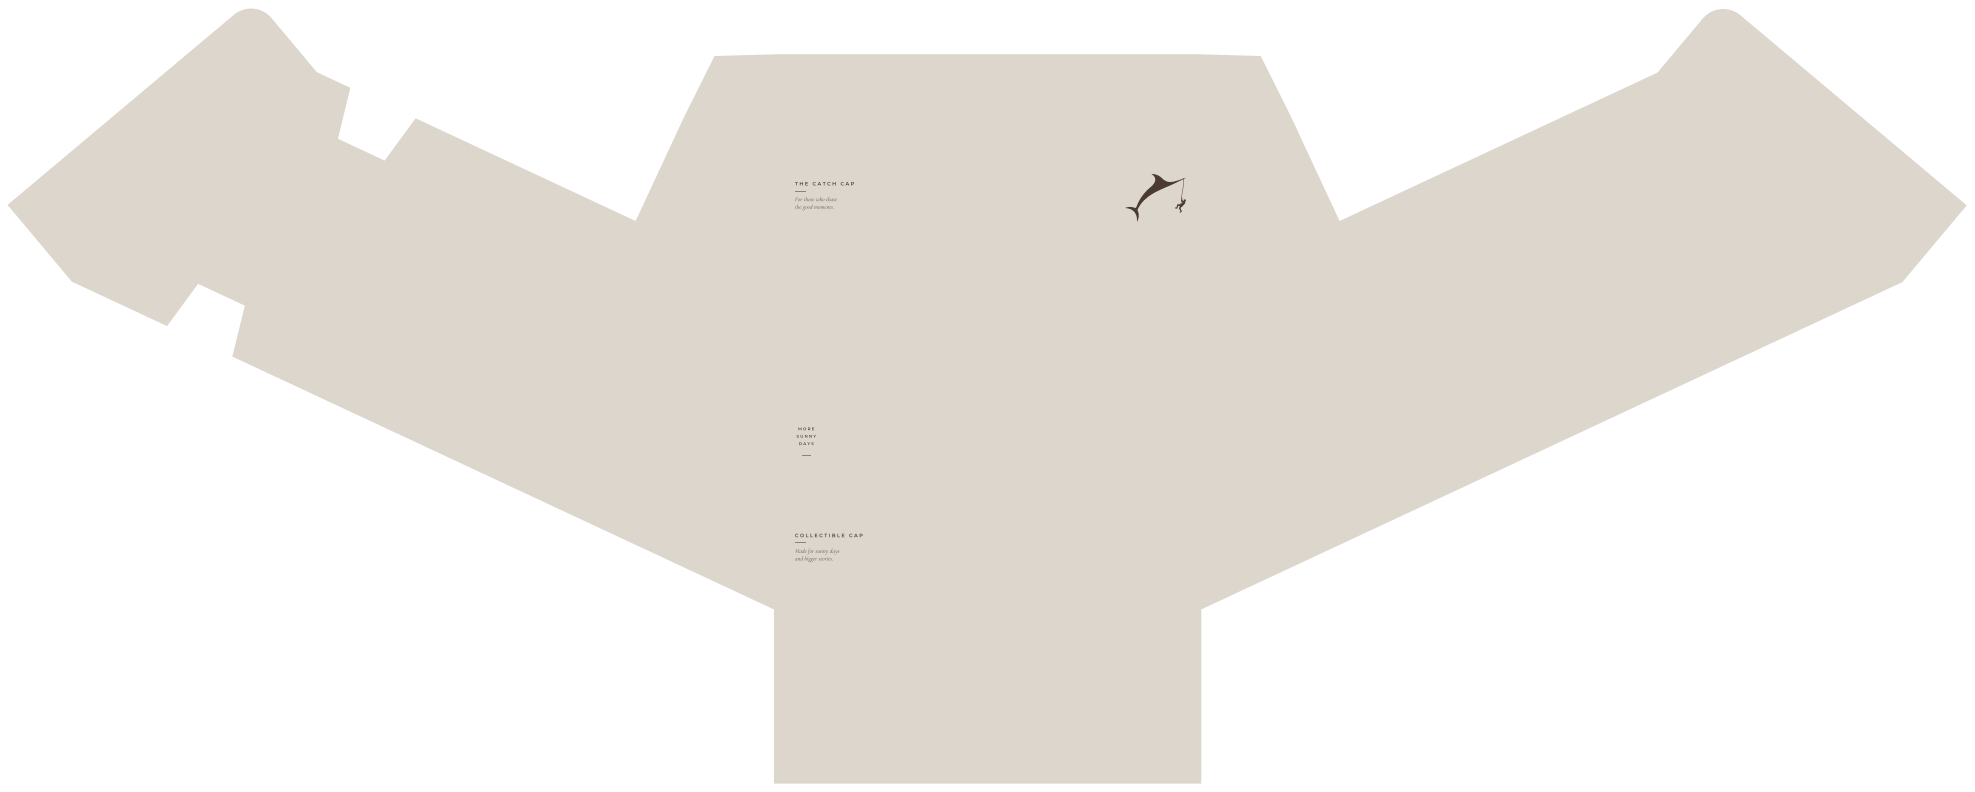
[picture p36: page 1]
