Tymur771/bank-transactions-site/cap-box/print/MFC-insert-RevC_design-template.pdf

### MFC — CAP INSERT · Rev C · шаблон для дизайна (вид с лицевой стороны, 1:1, мм)

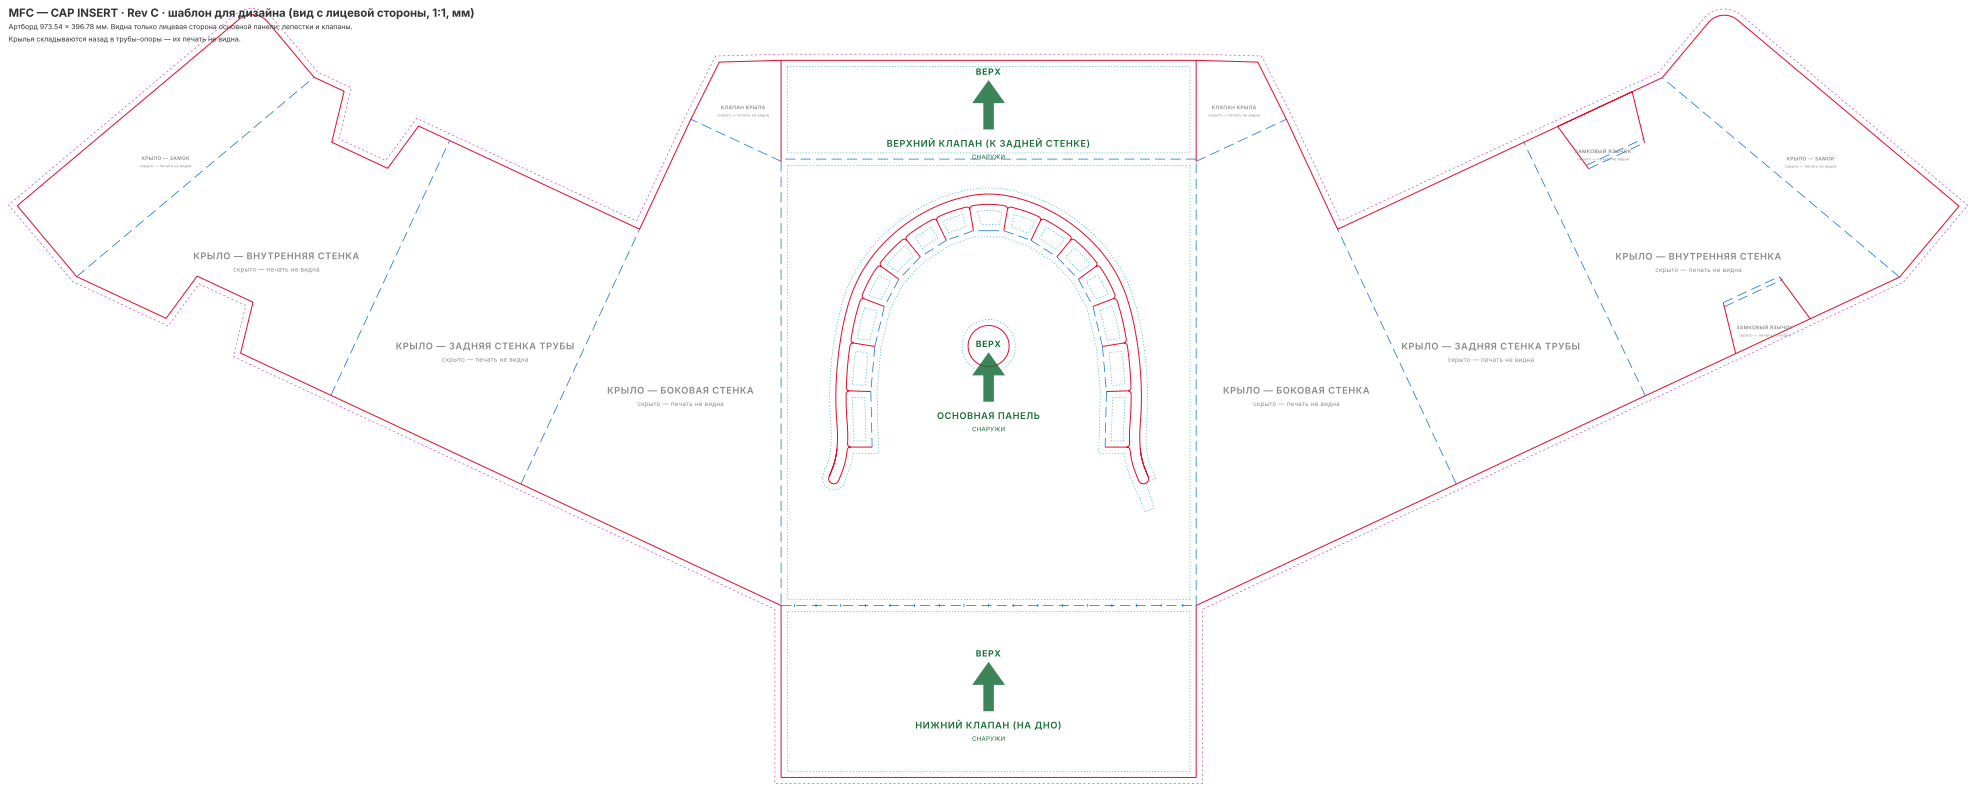
[picture p37: page 1]
ВЕРХ; ОСНОВНАЯ ПАНЕЛЬ; СНАРУЖИ; КЛАПАН КРЫЛА; КРЫЛО — ЗАМОК; ЗАМКОВЫЙ ЯЗЫЧОК

Артборд 973.54 × 396.78 мм. Видна только лицевая сторона основной панели, лепестки и клапаны.
Крылья складываются назад в трубы-опоры — их печать не видна.

скрыто — печать не видна

ВЕРХНИЙ КЛАПАН (К ЗАДНЕЙ СТЕНКЕ)

КРЫЛО — ВНУТРЕННЯЯ СТЕНКА

КРЫЛО — ЗАДНЯЯ СТЕНКА ТРУБЫ

КРЫЛО — БОКОВАЯ СТЕНКА

НИЖНИЙ КЛАПАН (НА ДНО)
