Tymur771/bank-transactions-site/cap-box/design/variants/coast/MFC-box-RevN_design-coast_inside_PRINT-mirrored.pdf

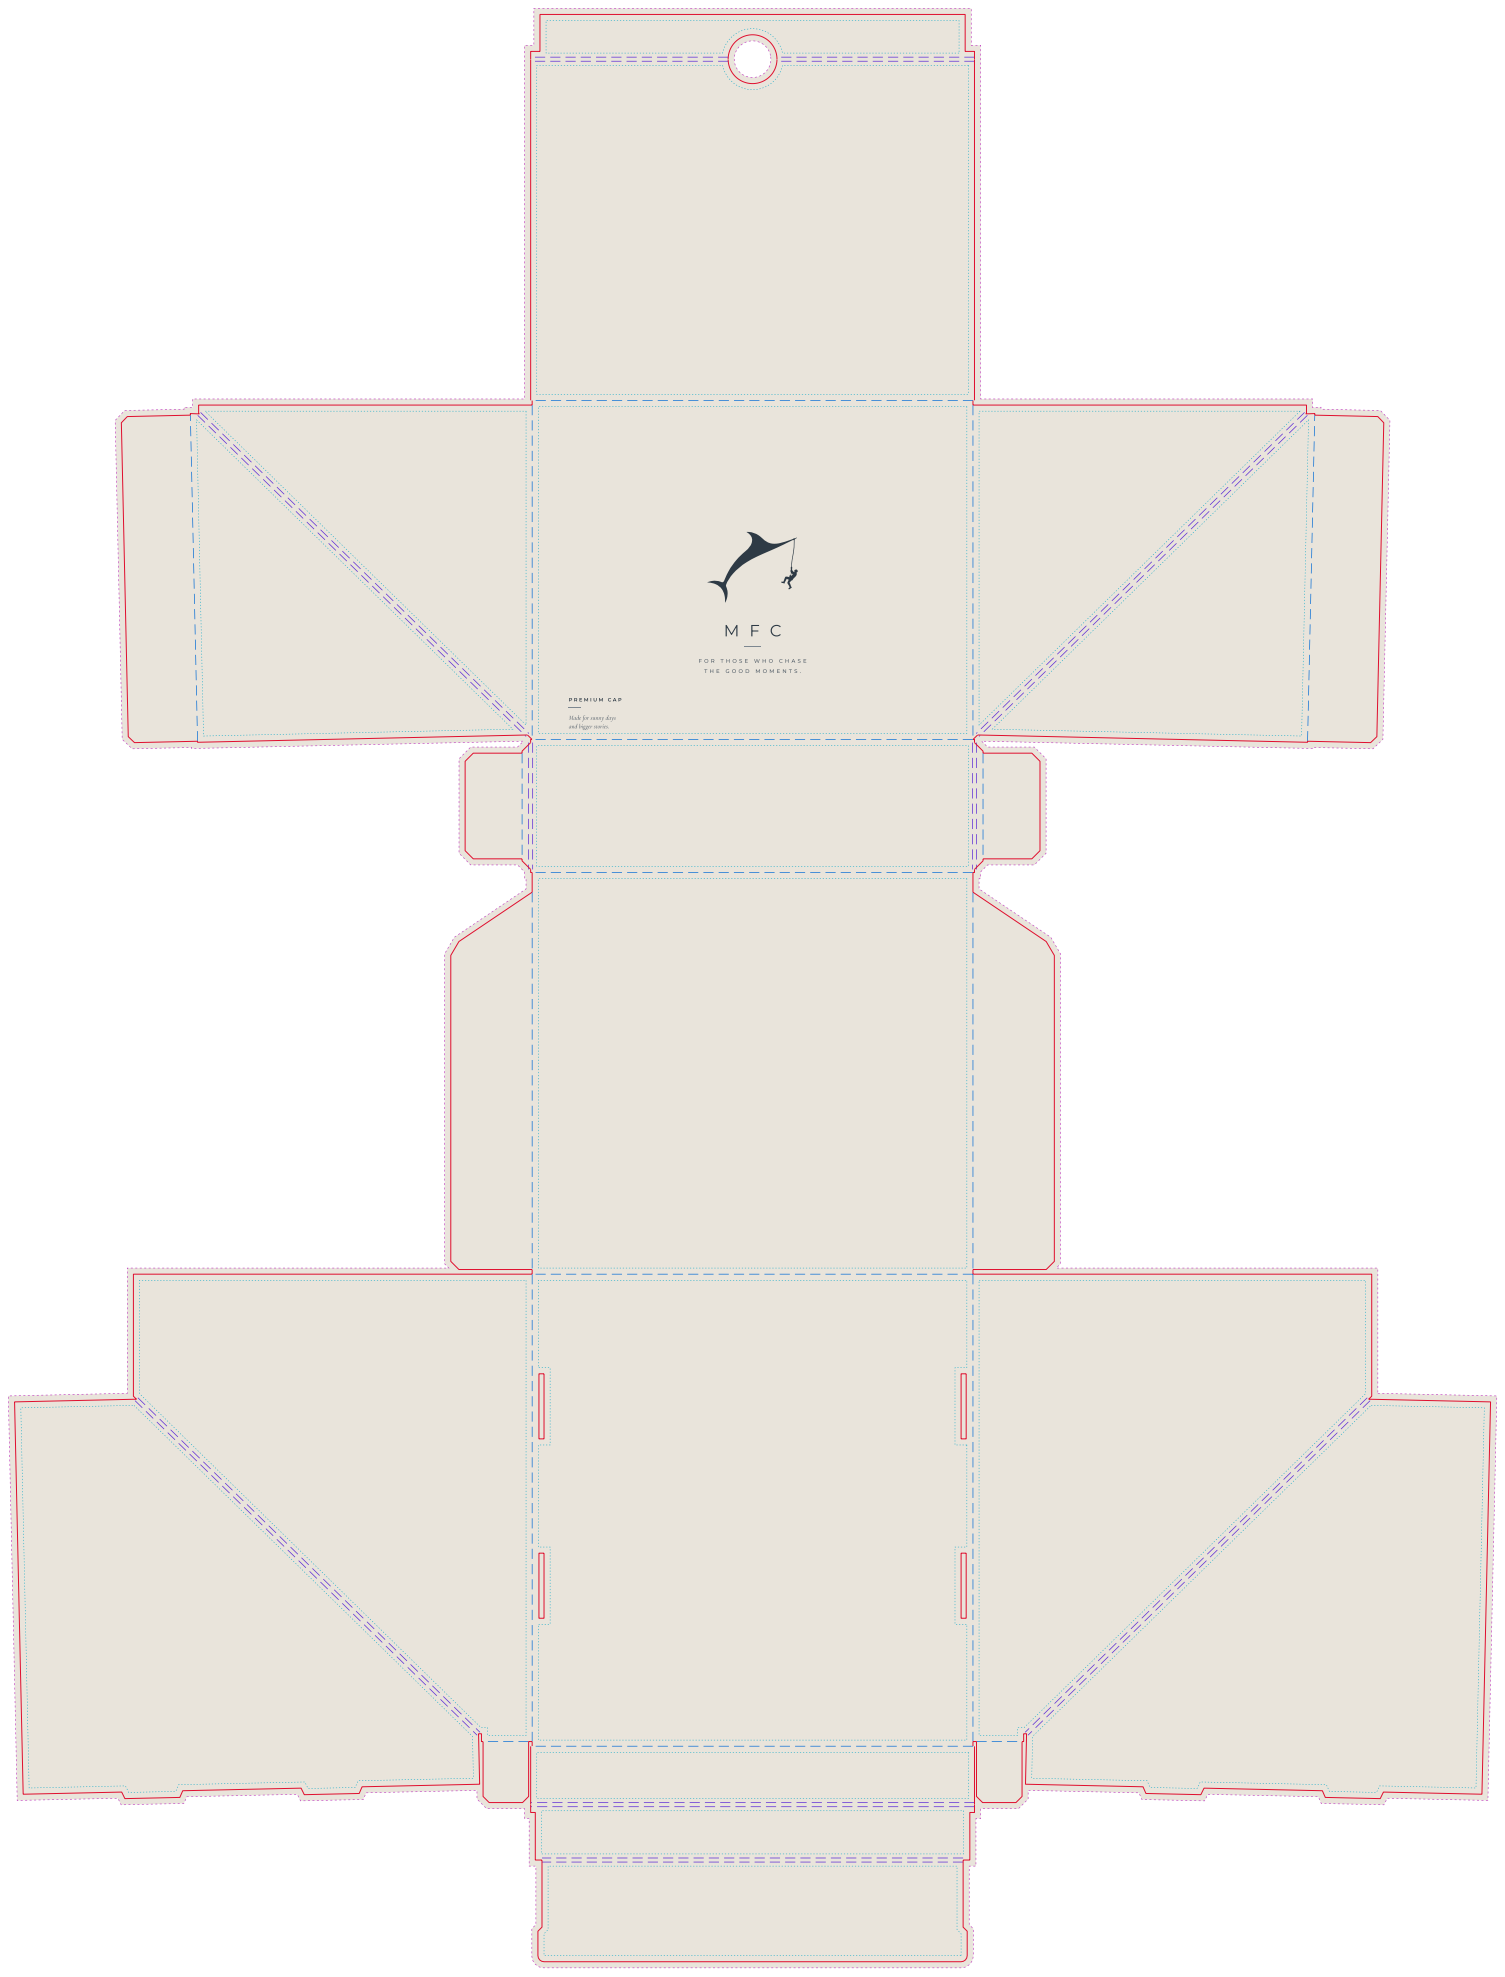
[picture p38: page 1]
