Tymur771/bank-transactions-site/cap-box/design/variants/coast/MFC-box-RevN_design-coast_outside_outlined.pdf

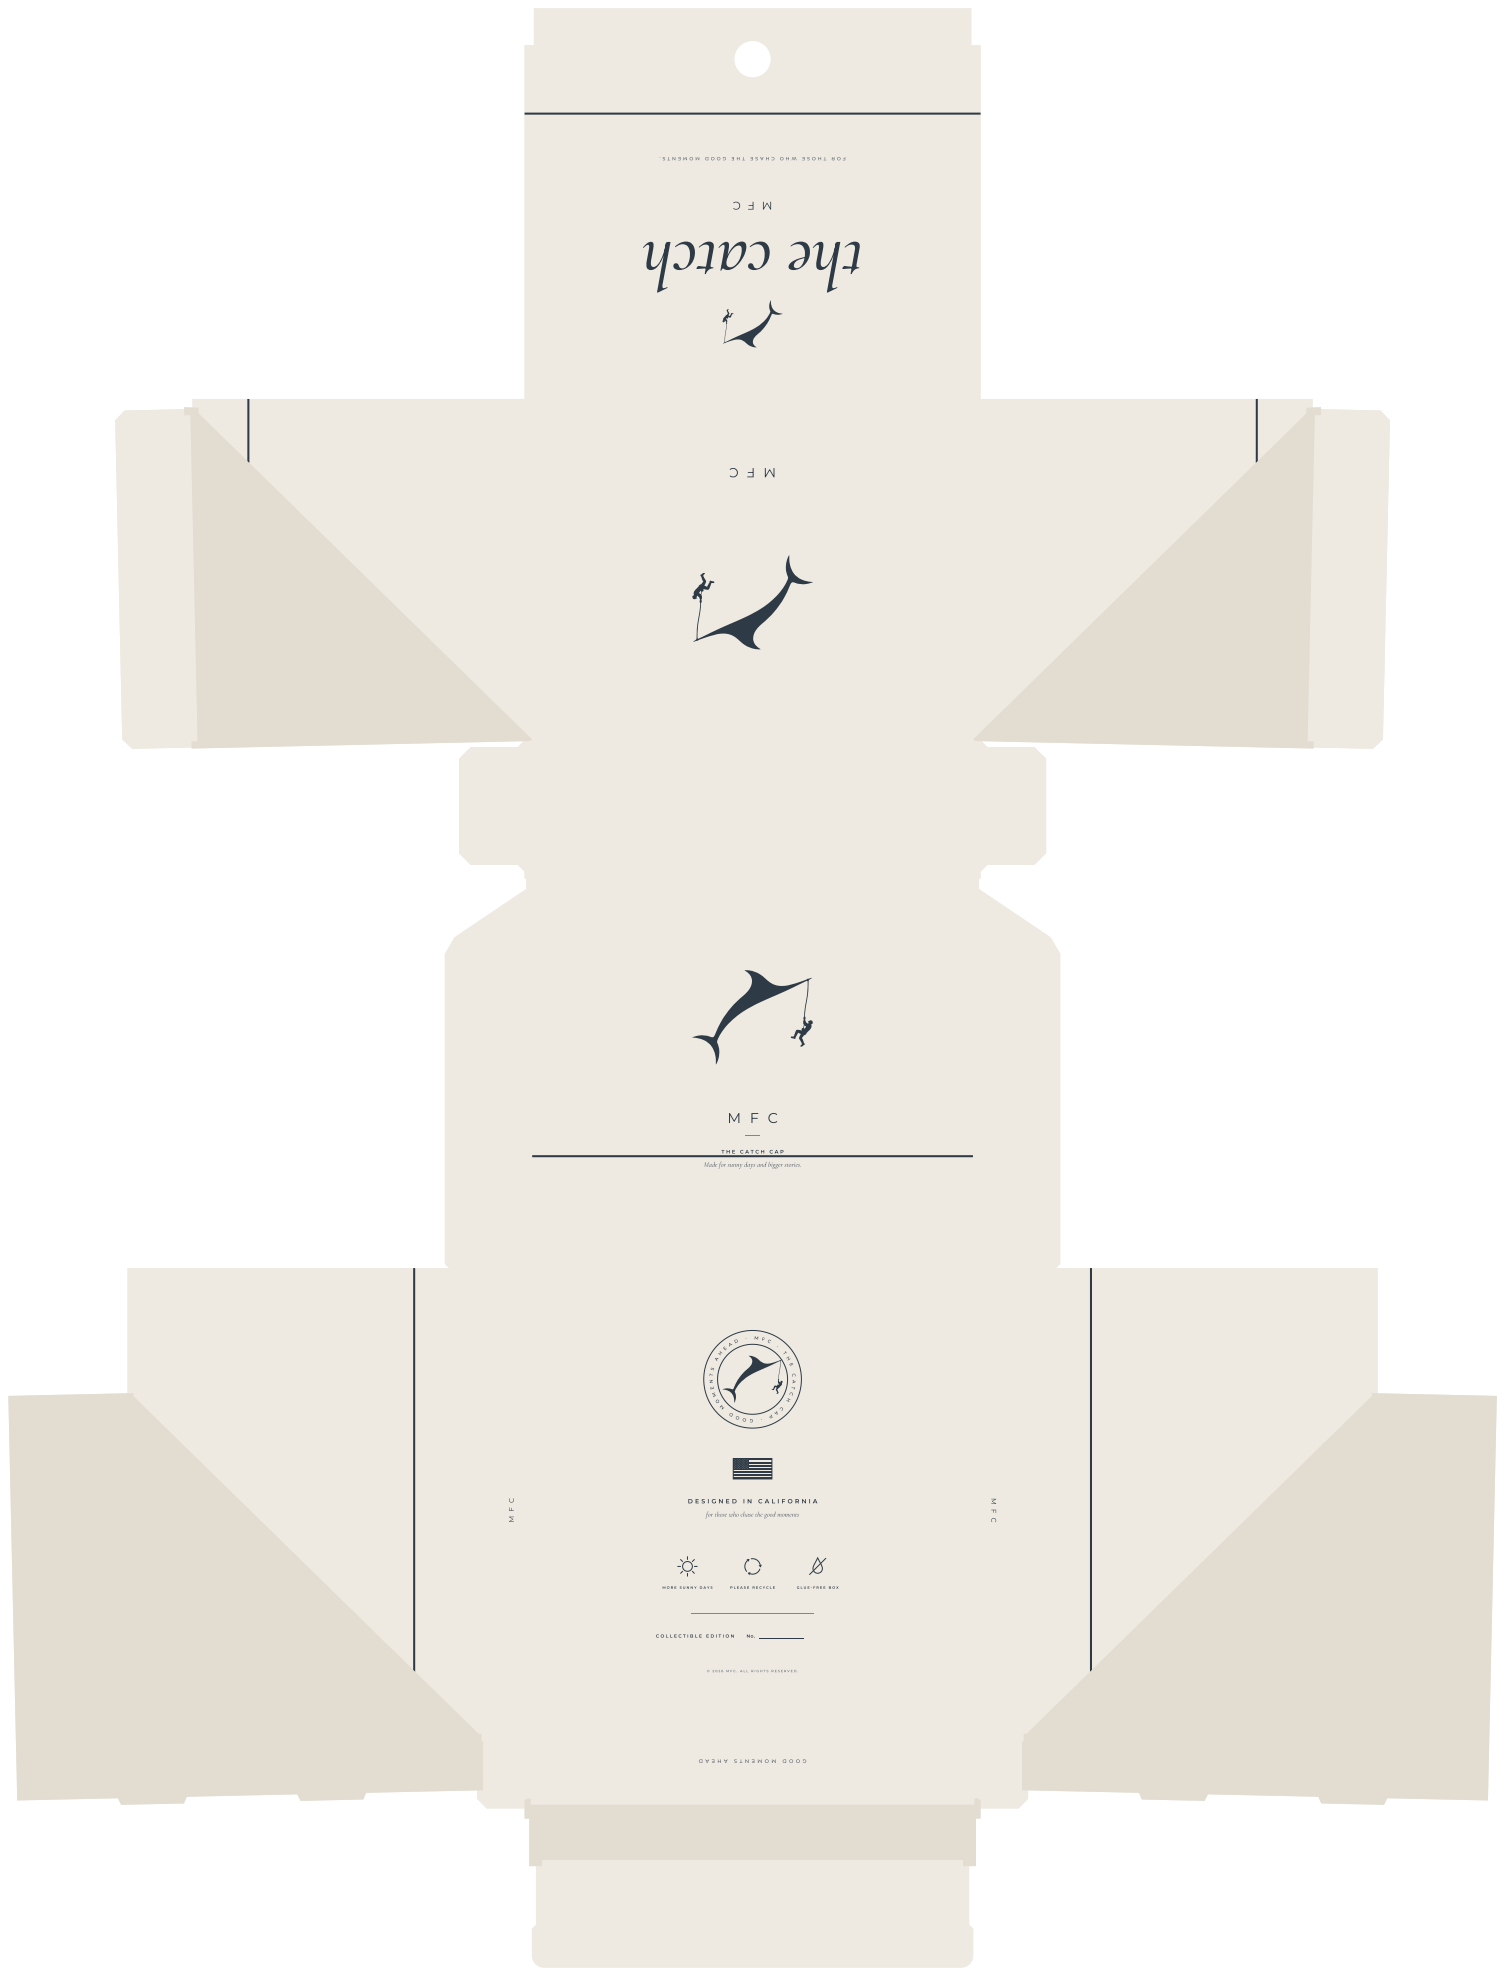
[picture p39: page 1]
