Tymur771/bank-transactions-site/cap-box/design/variants/coast/MFC-insert-RevC_design-coast_outlined.pdf

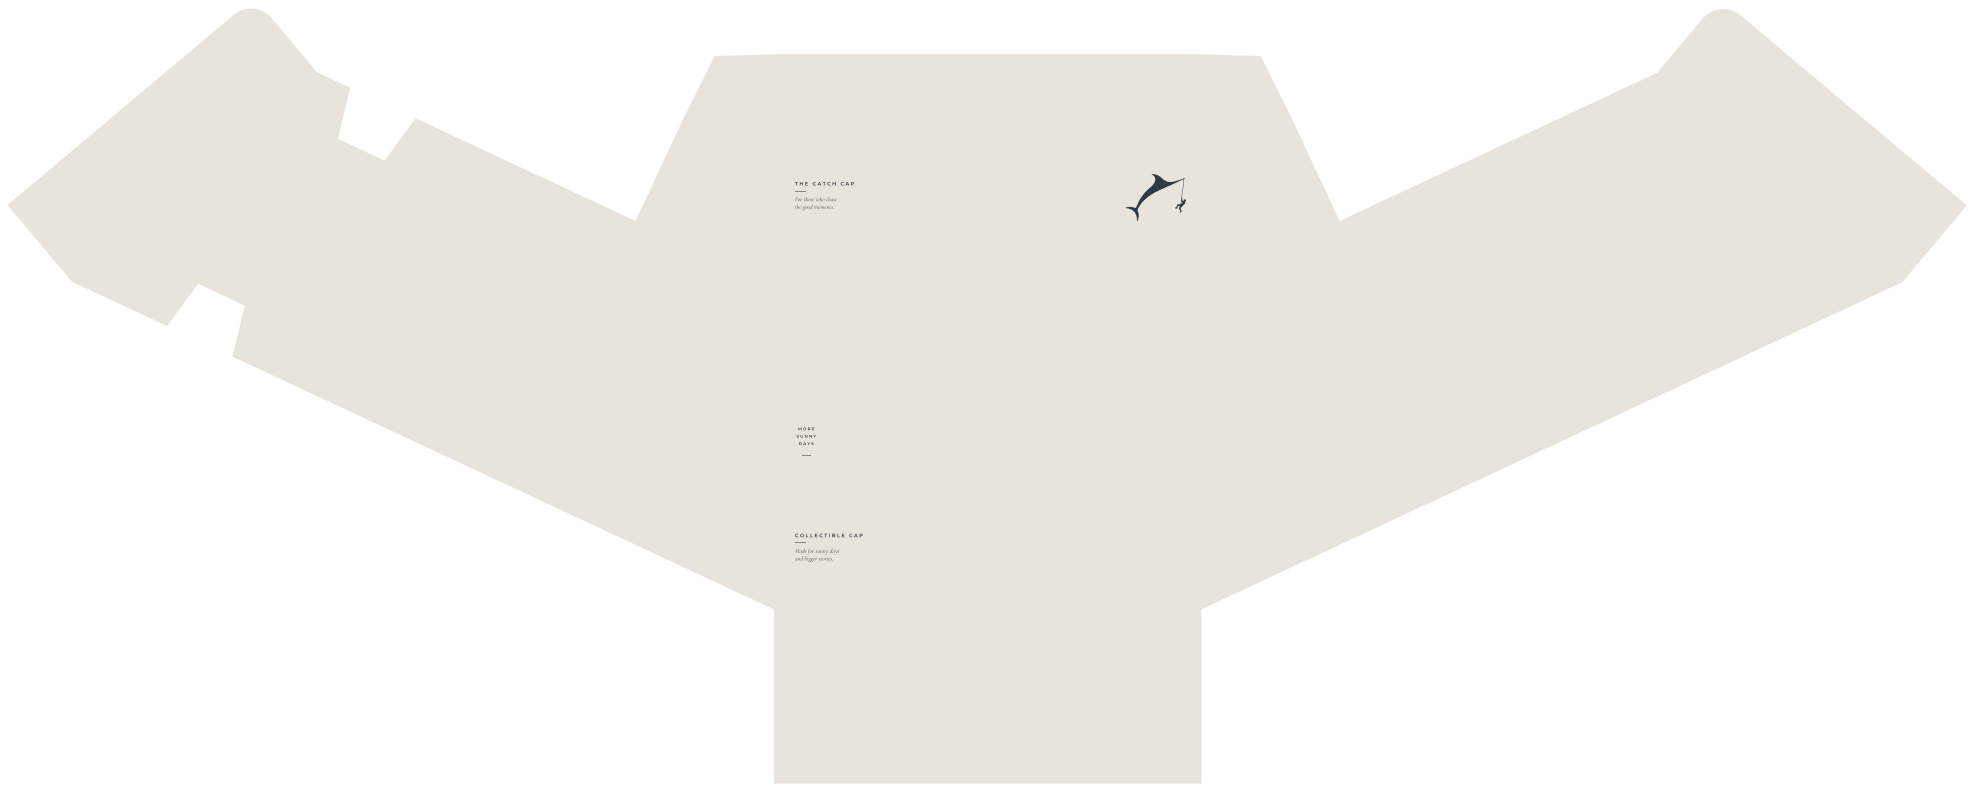
[picture p40: page 1]
