Tymur771/bank-transactions-site/cap-box/design/variants/mark/MFC-box-RevN_design-mark_inside_PRINT-mirrored.pdf

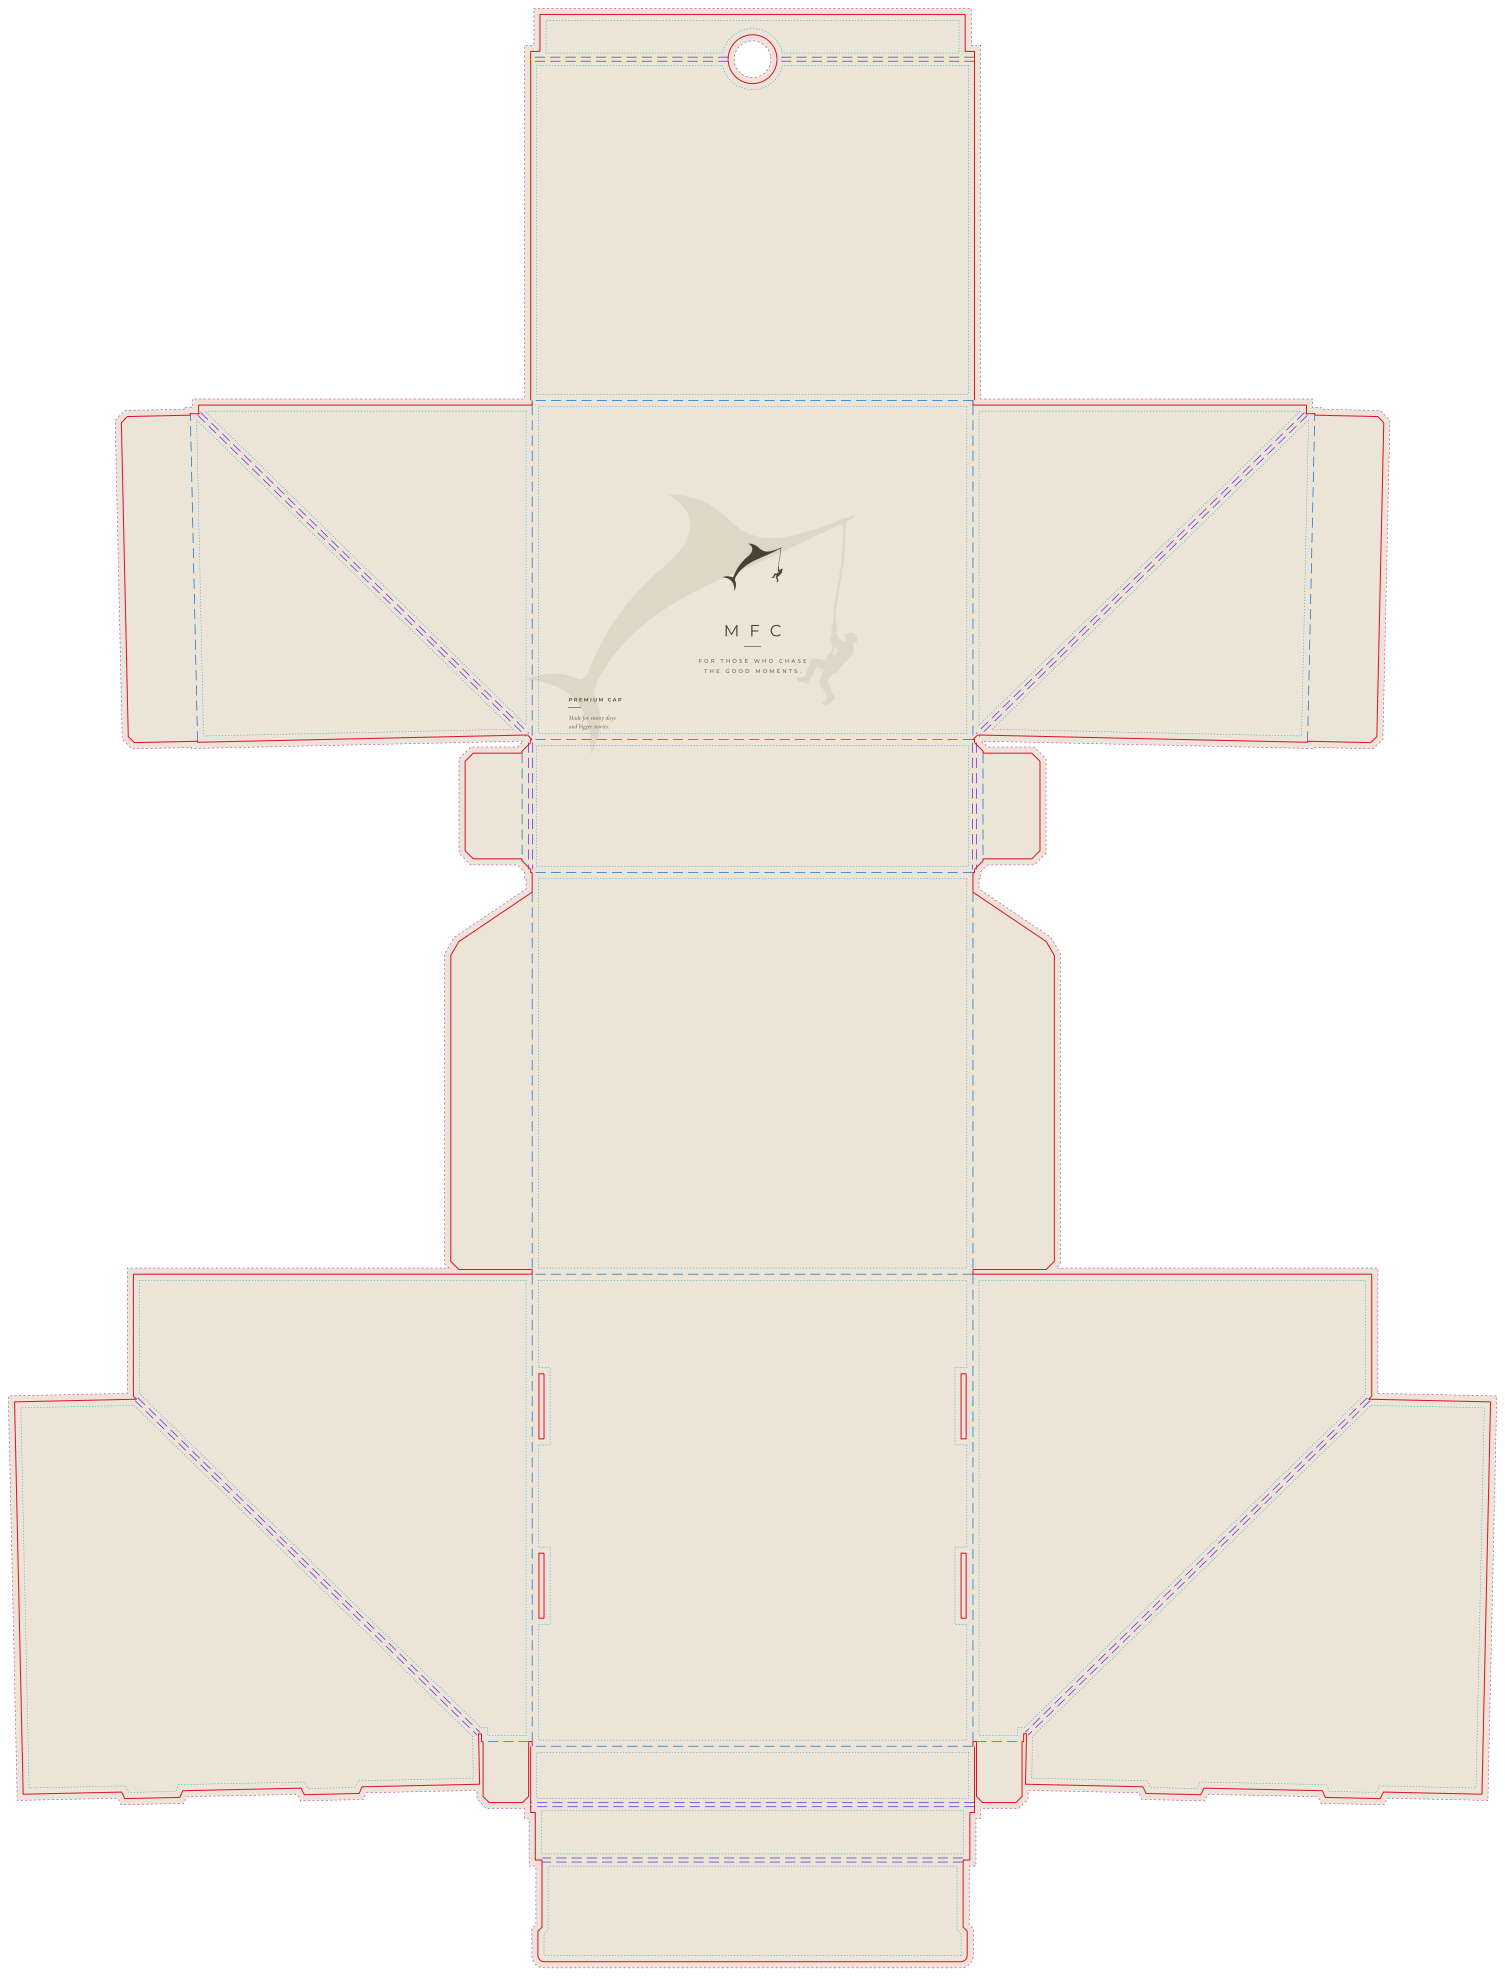
[picture p41: page 1]
