Tymur771/bank-transactions-site/cap-box/design/variants/mark/MFC-box-RevN_design-mark_outside_outlined.pdf

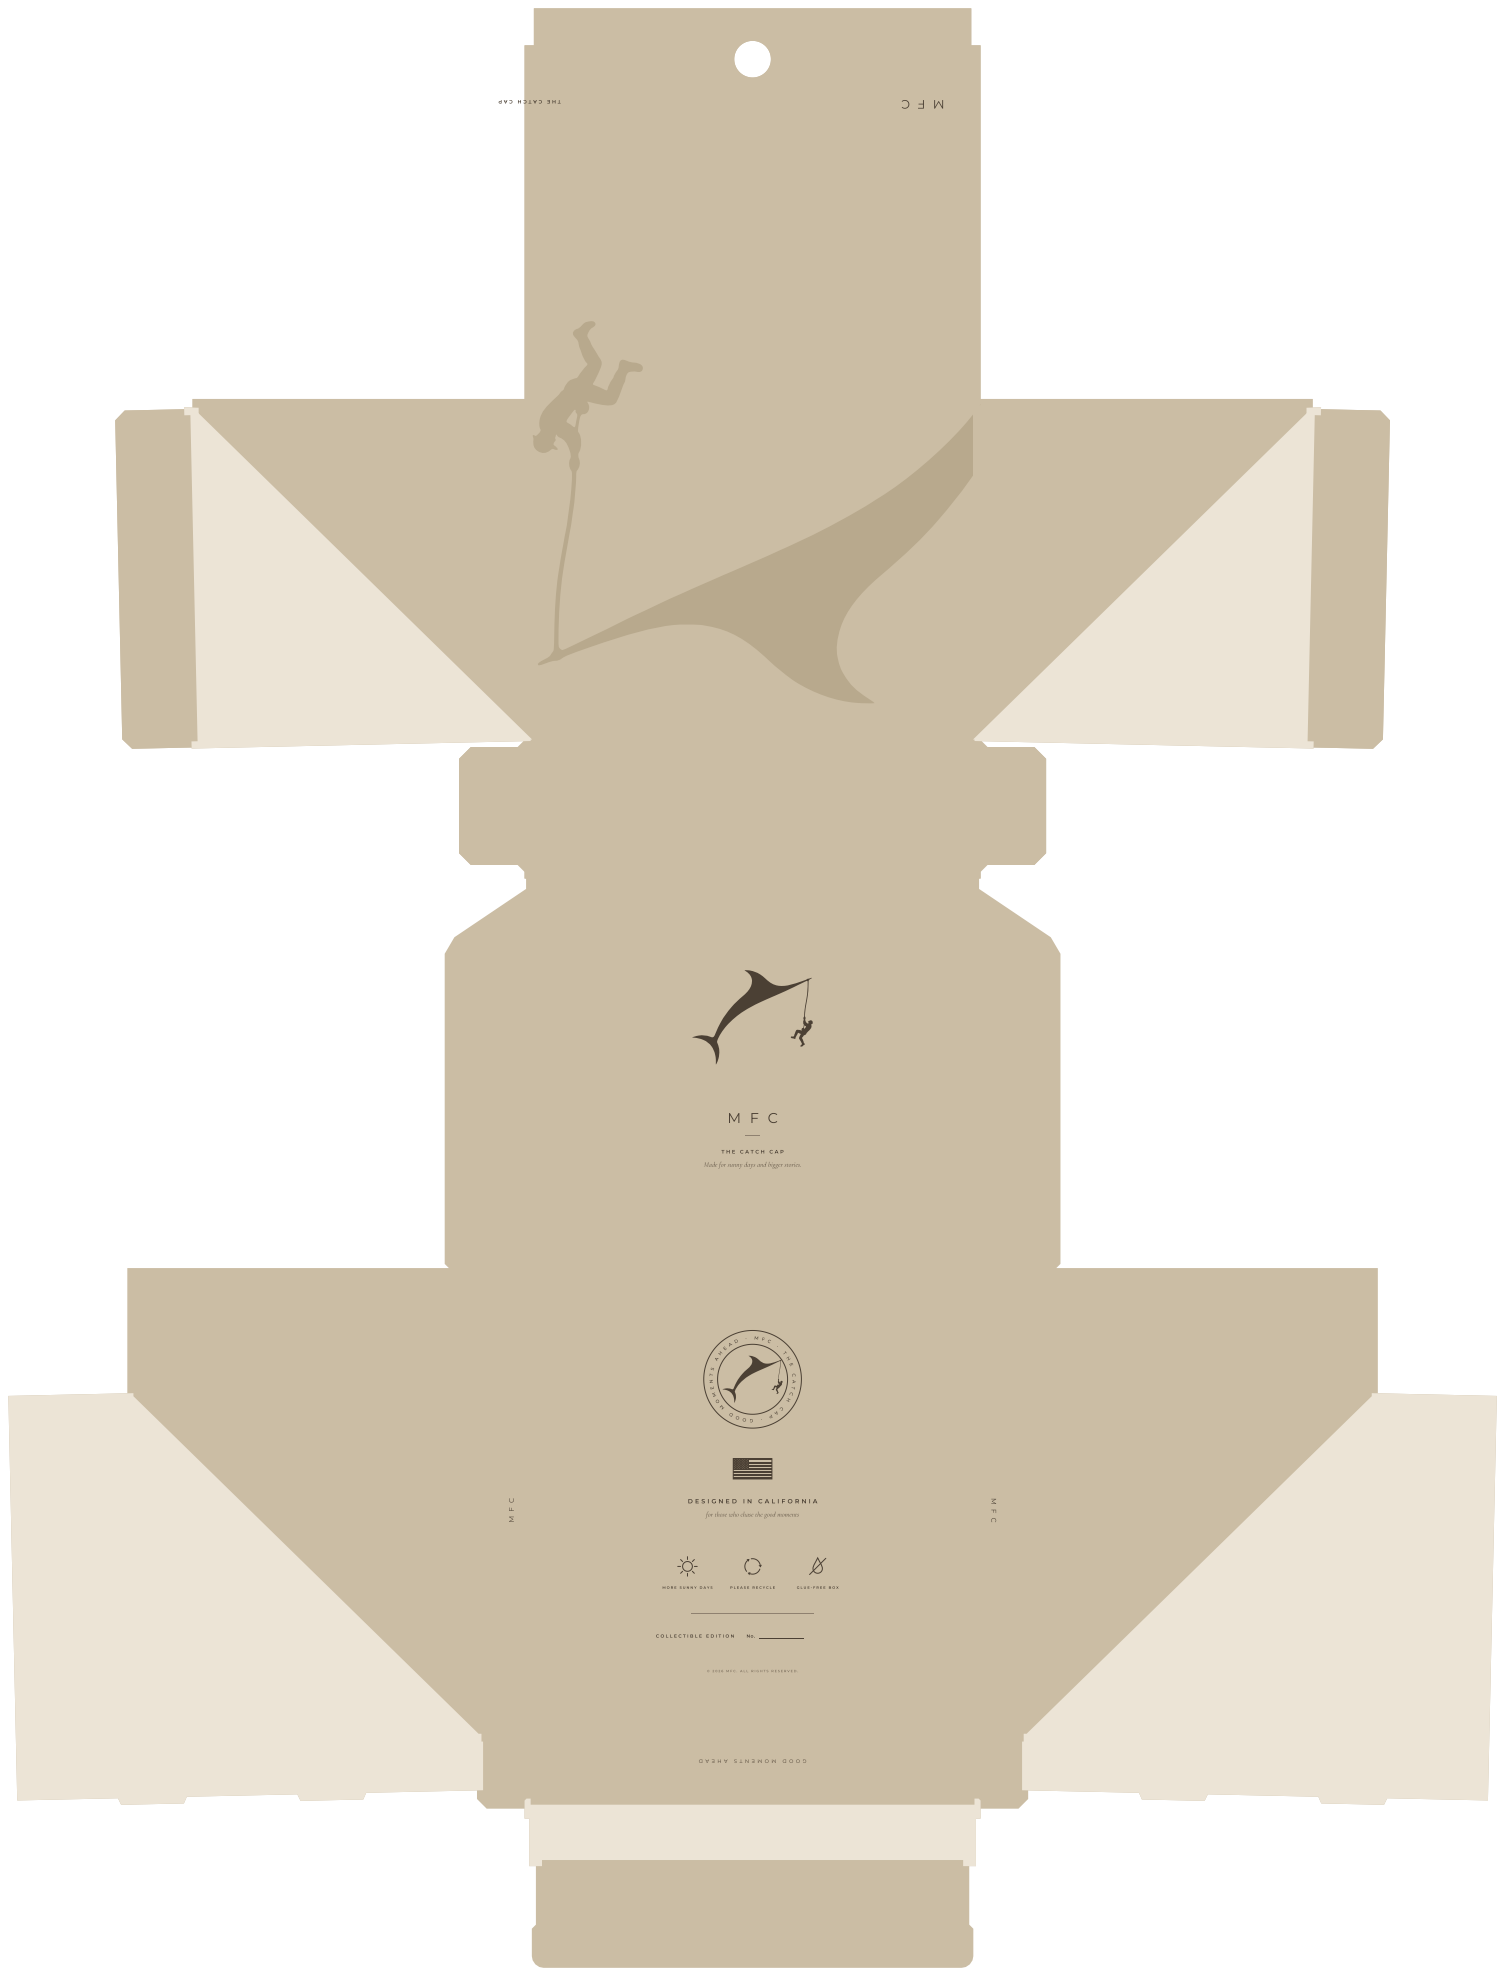
[picture p42: page 1]
