Tymur771/bank-transactions-site/cap-box/design/variants/mark/MFC-insert-RevC_design-mark_outlined.pdf

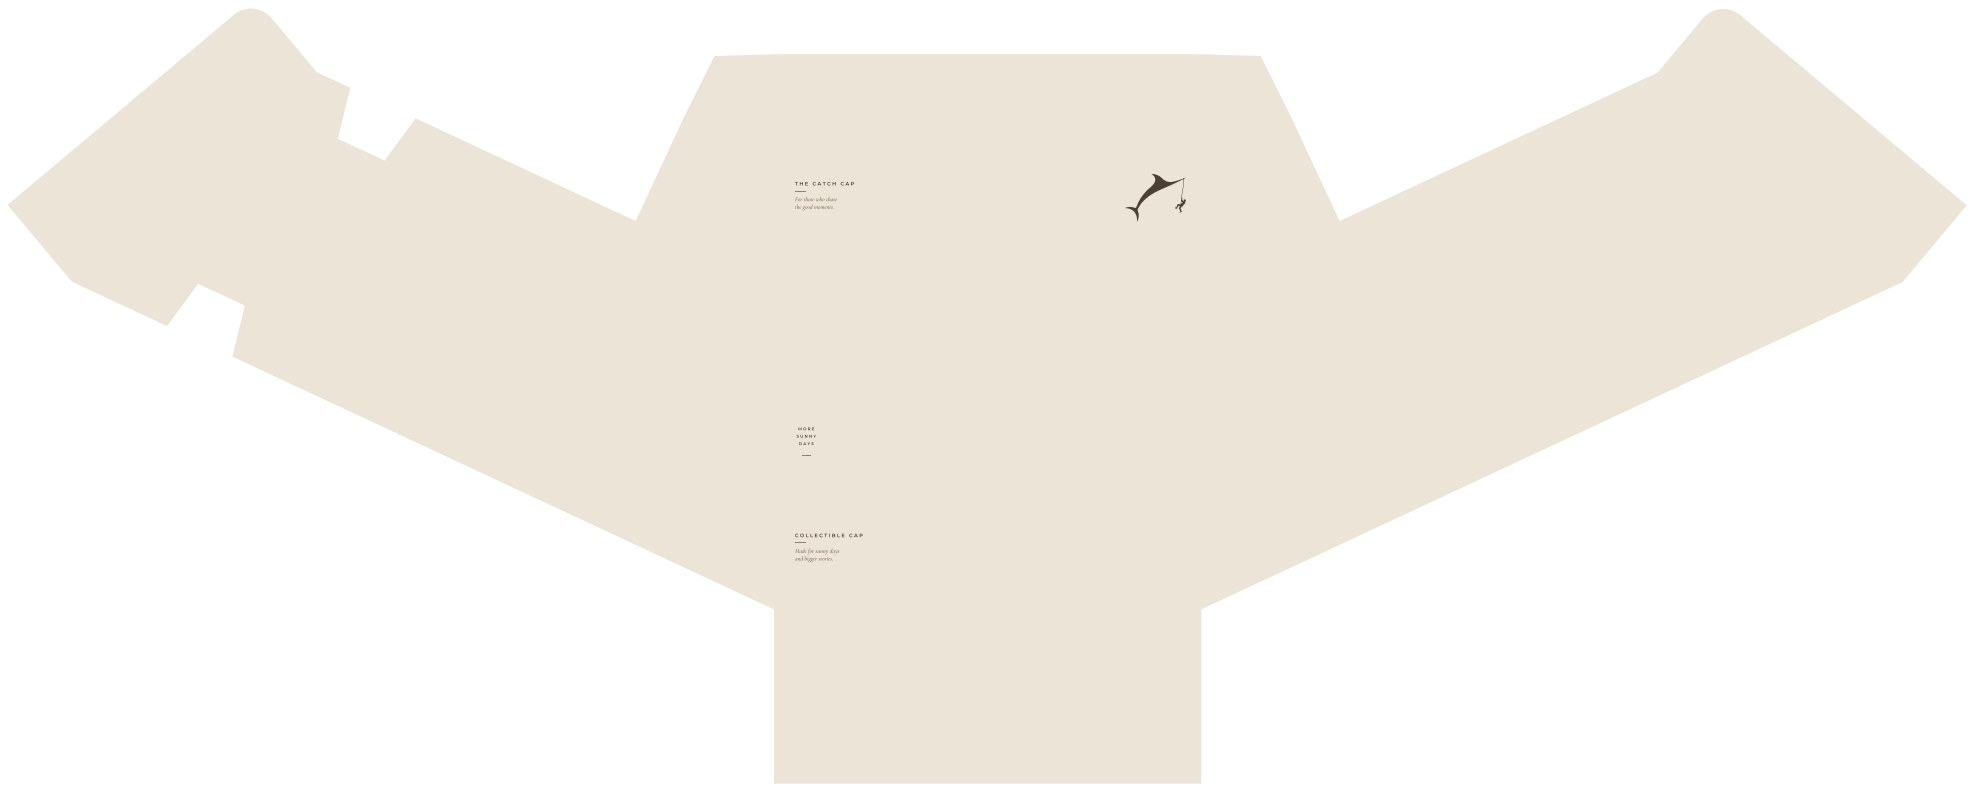
[picture p43: page 1]
