Tymur771/bank-transactions-site/cap-box/design/variants/noir/MFC-box-RevN_design-noir_inside_PRINT-mirrored.pdf

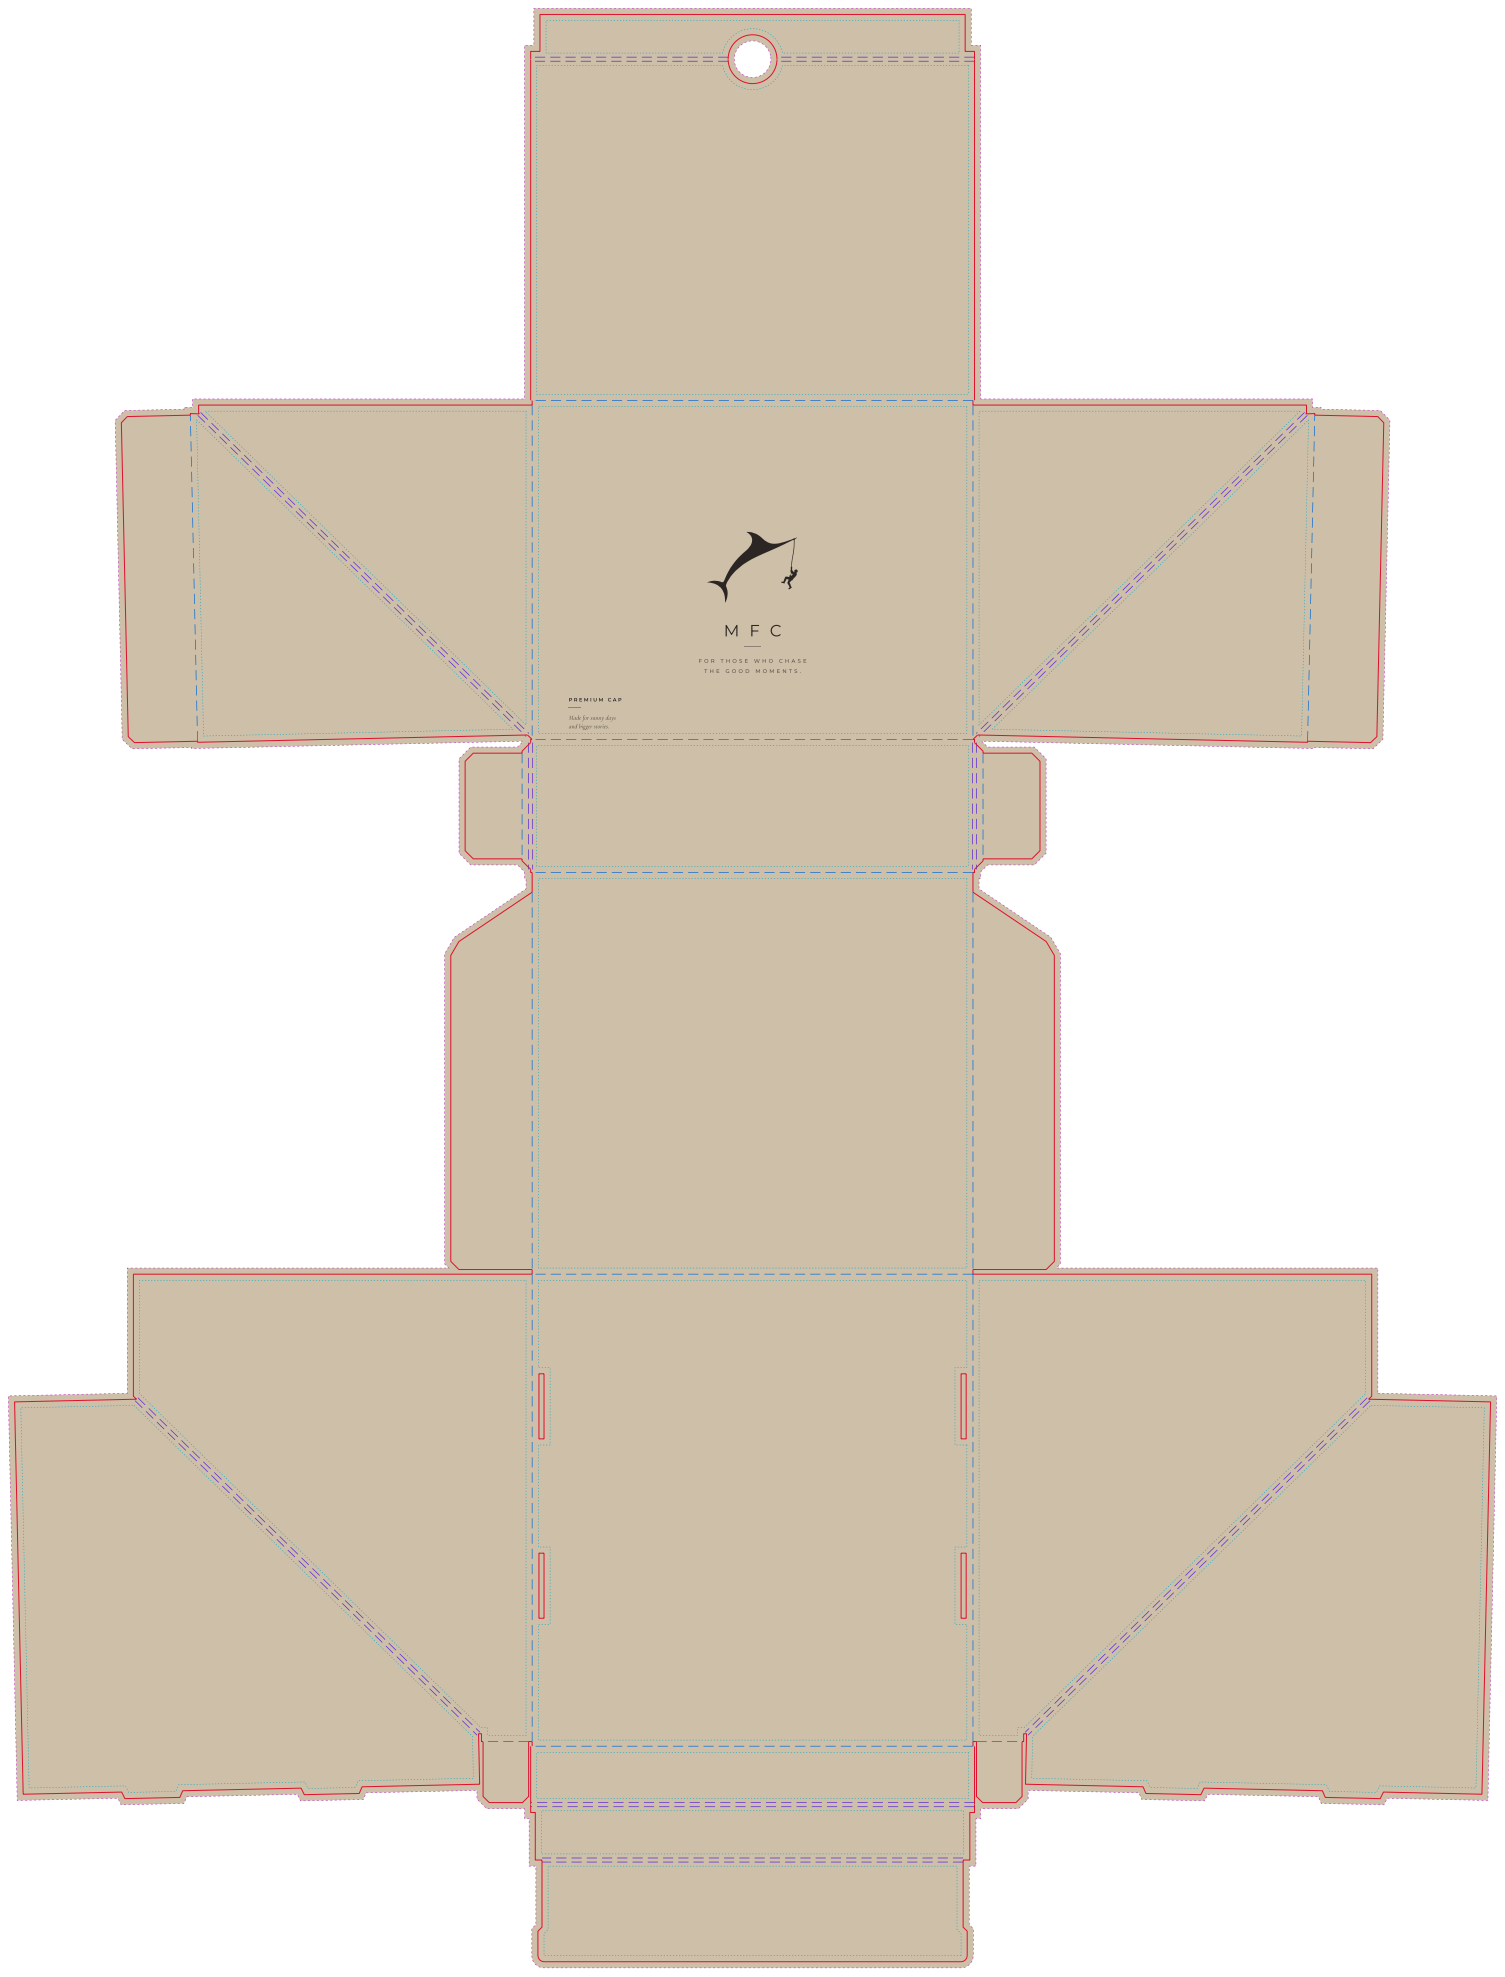
[picture p44: page 1]
