Tymur771/bank-transactions-site/cap-box/design/variants/noir/MFC-box-RevN_design-noir_outside_outlined.pdf

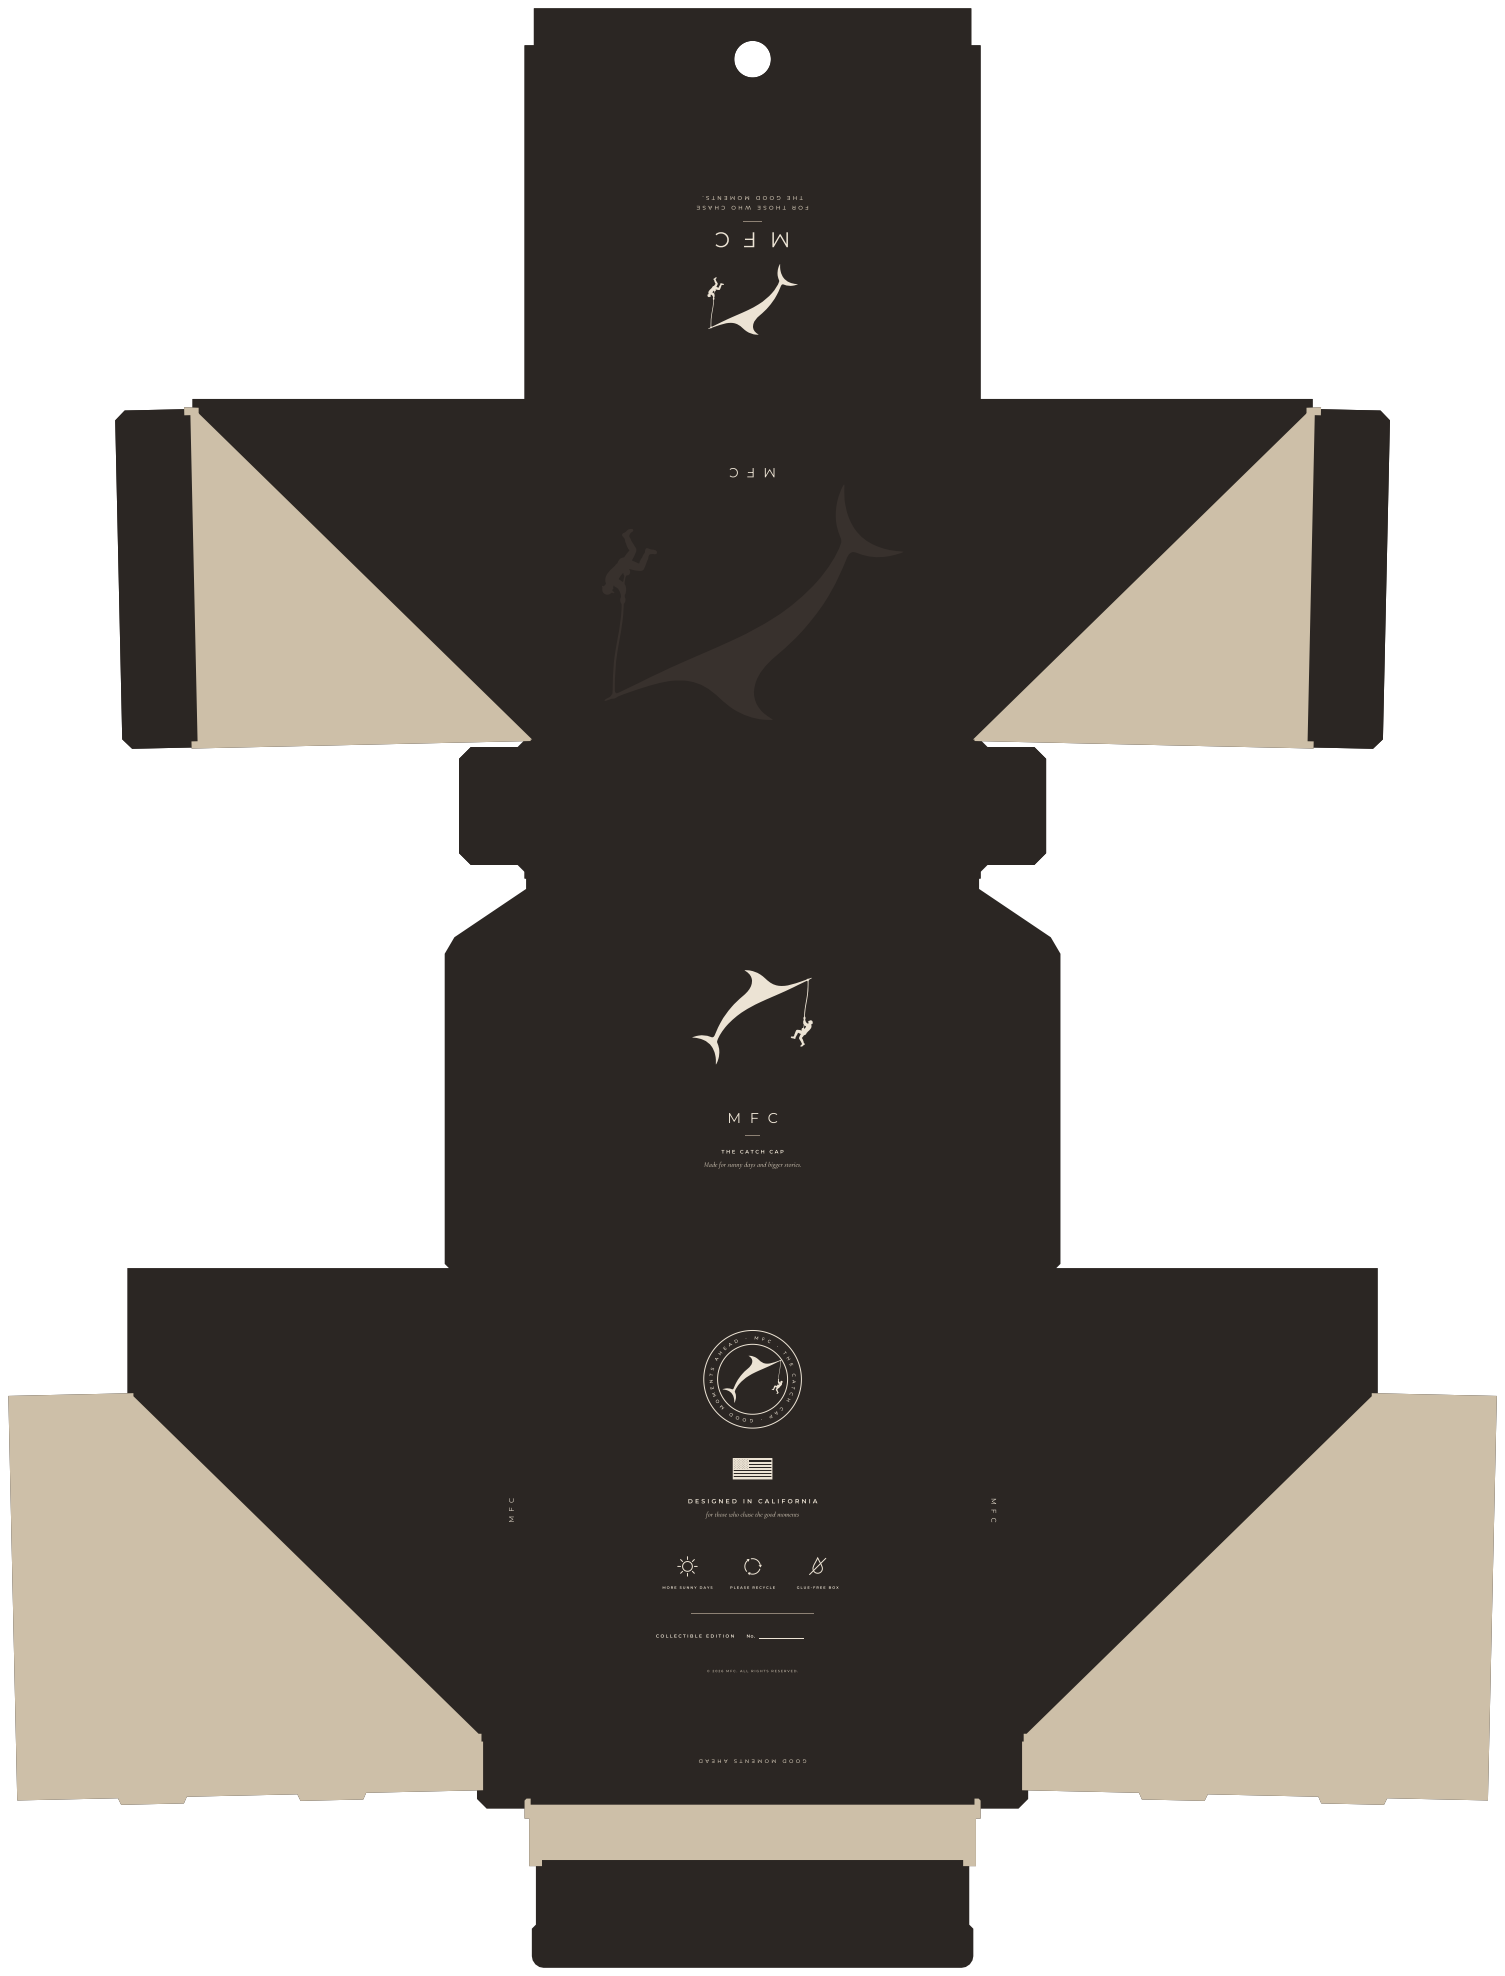
[picture p45: page 1]
