Tymur771/bank-transactions-site/cap-box/design/variants/noir/MFC-insert-RevC_design-noir_outlined.pdf

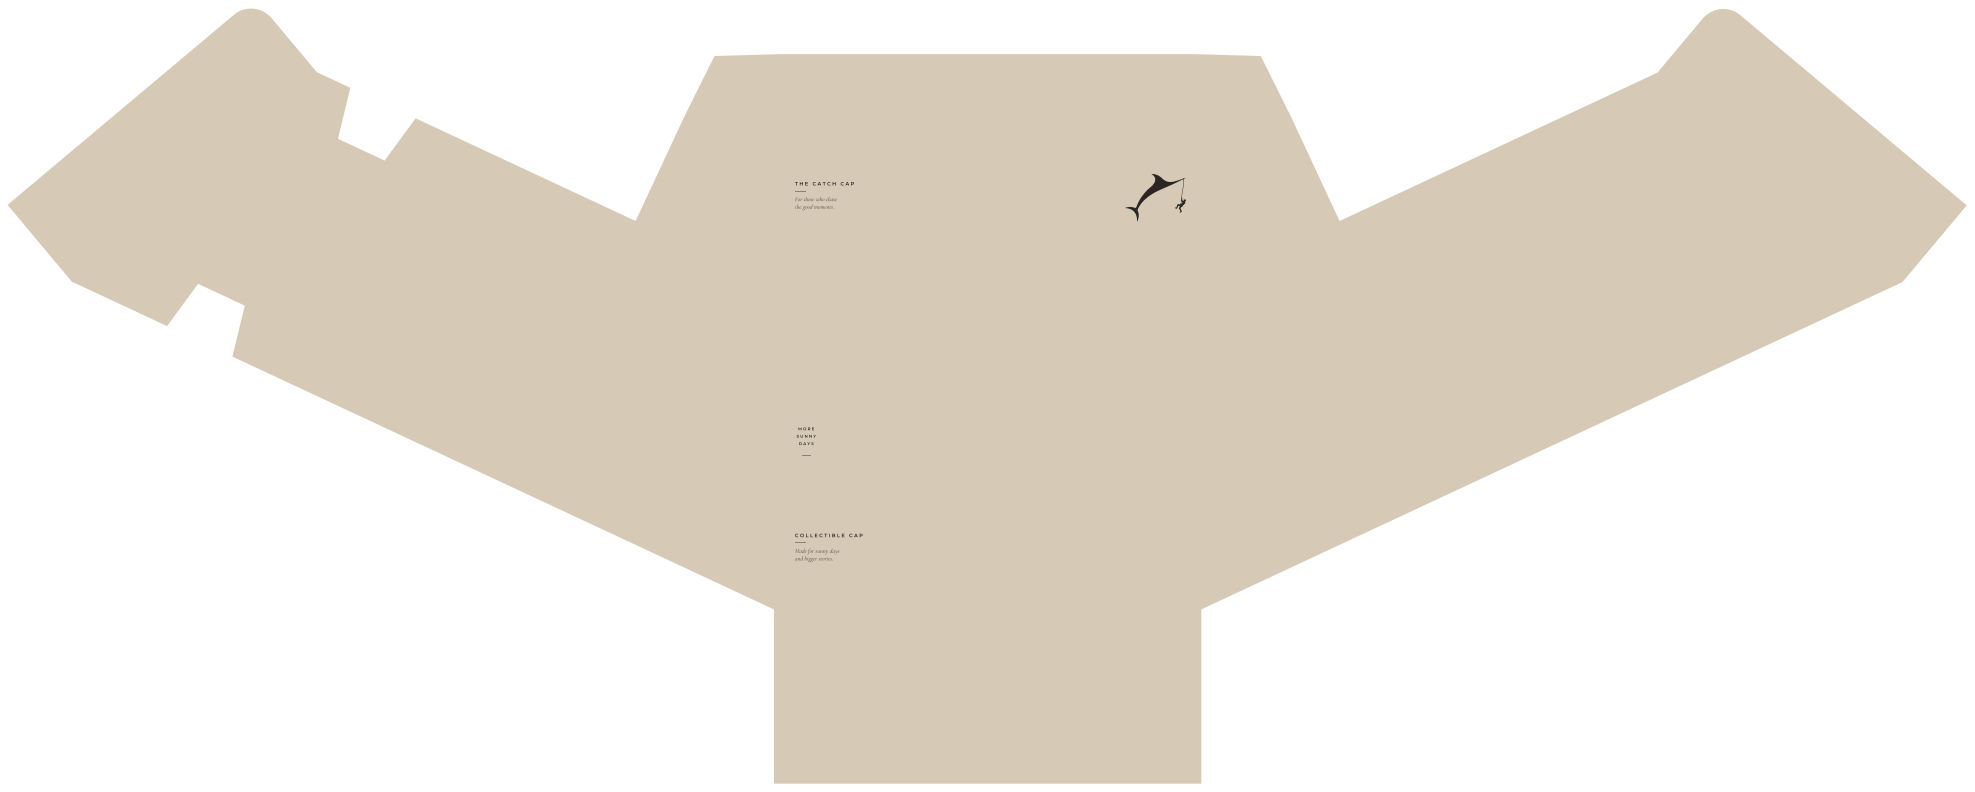
[picture p46: page 1]
