Tymur771/bank-transactions-site/cap-box/design/variants/sun/MFC-box-RevN_design-sun_inside_PRINT-mirrored.pdf

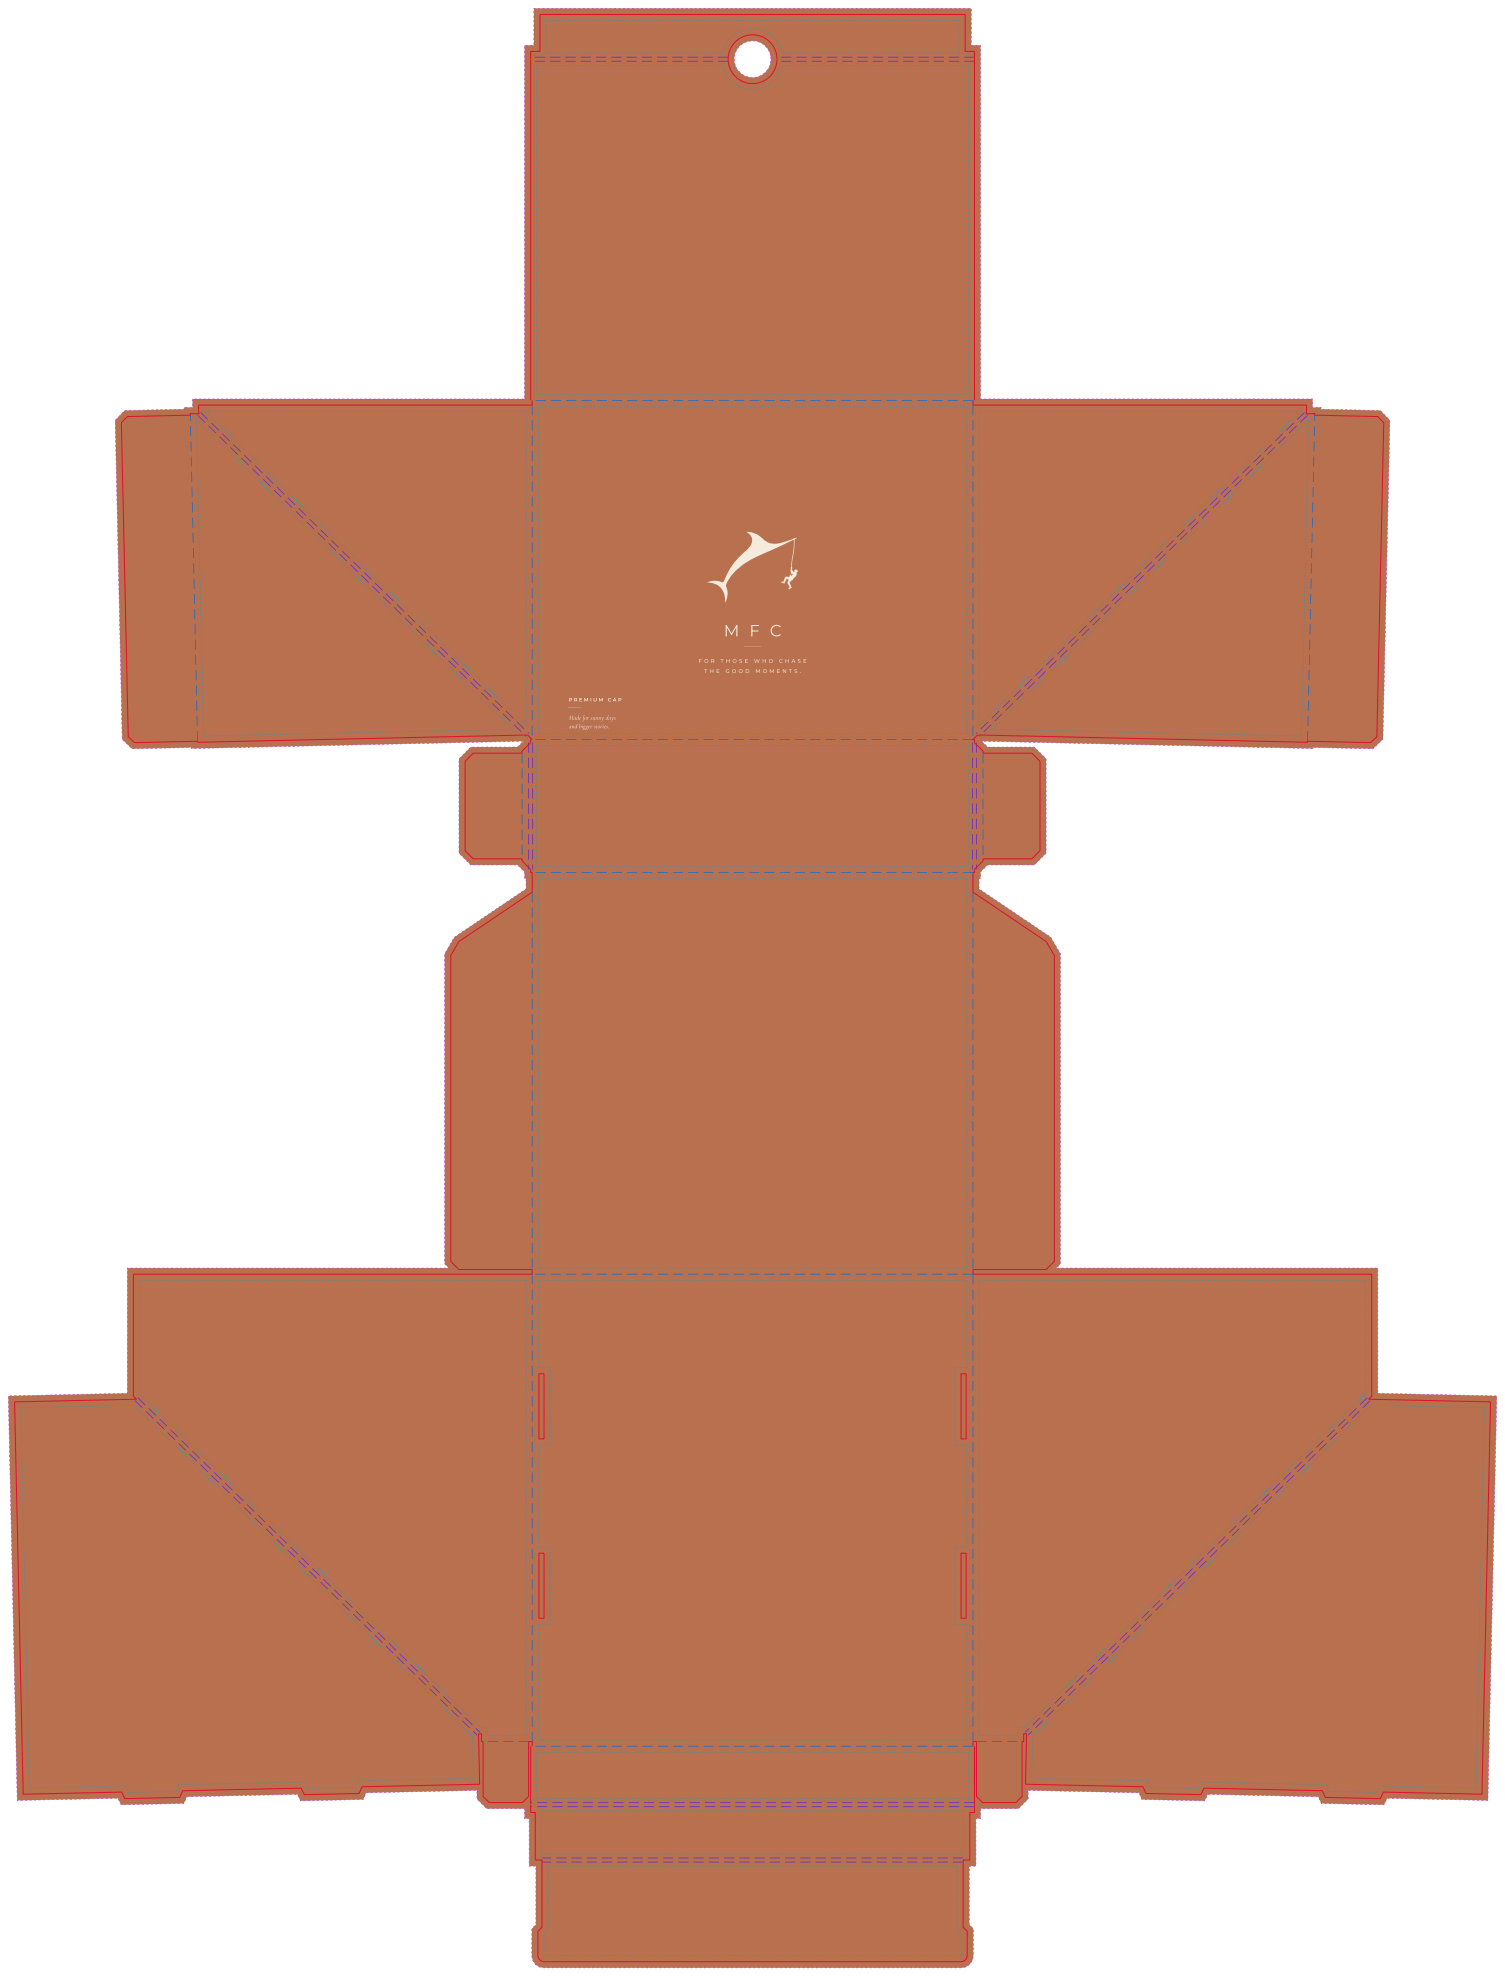
[picture p47: page 1]
