Tymur771/bank-transactions-site/cap-box/design/variants/sun/MFC-box-RevN_design-sun_outside_outlined.pdf

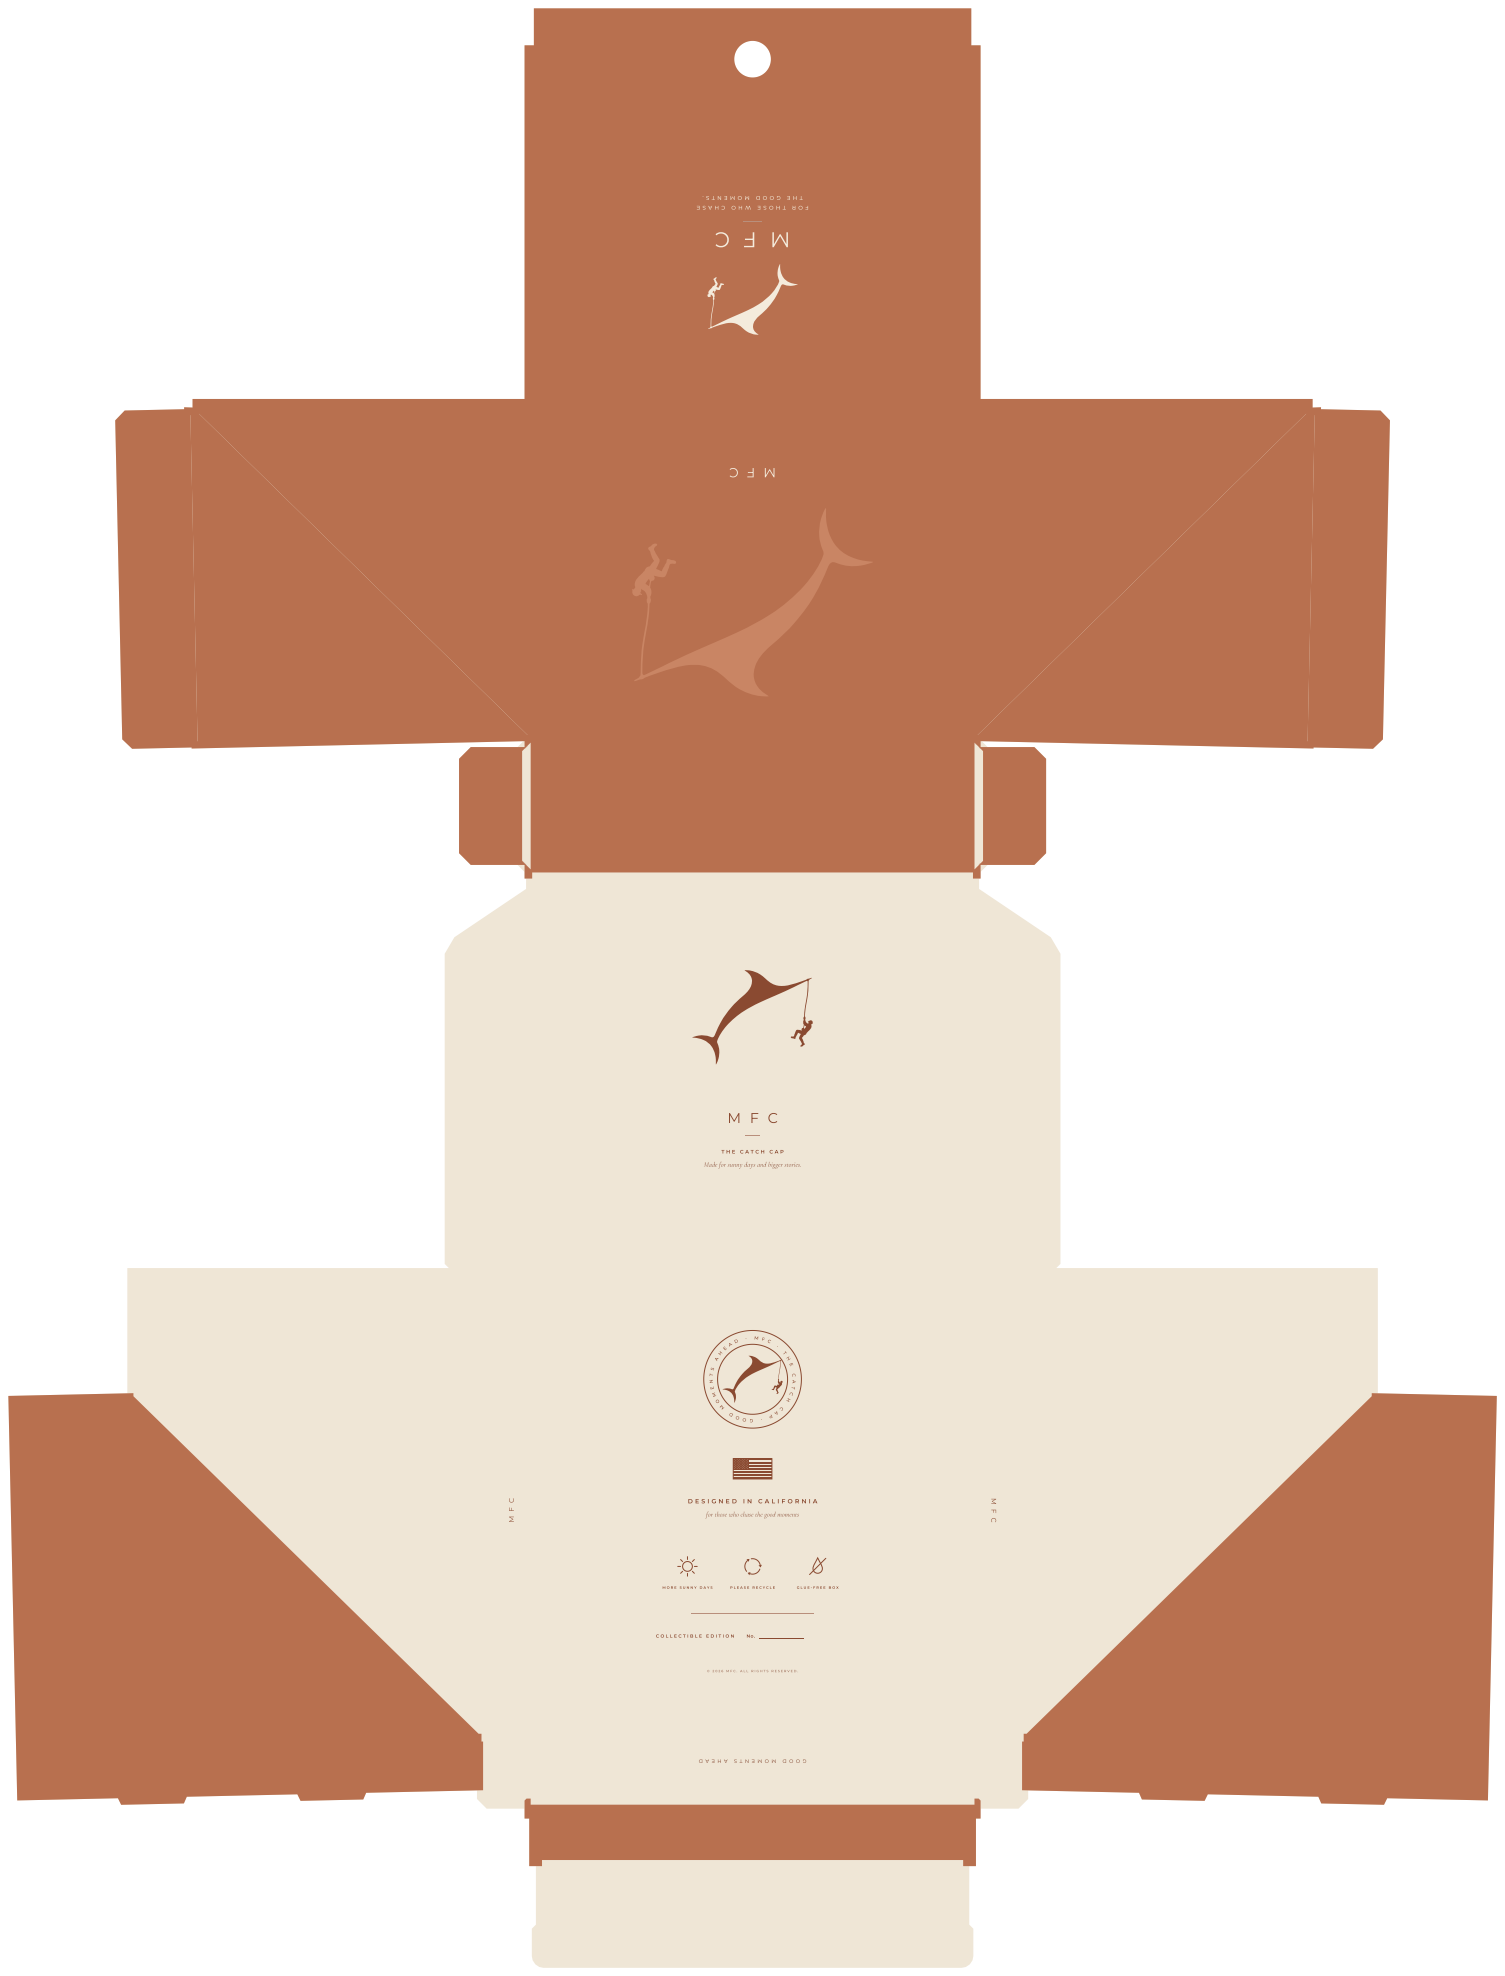
[picture p48: page 1]
