Tymur771/bank-transactions-site/cap-box/design/variants/sun/MFC-insert-RevC_design-sun_outlined.pdf

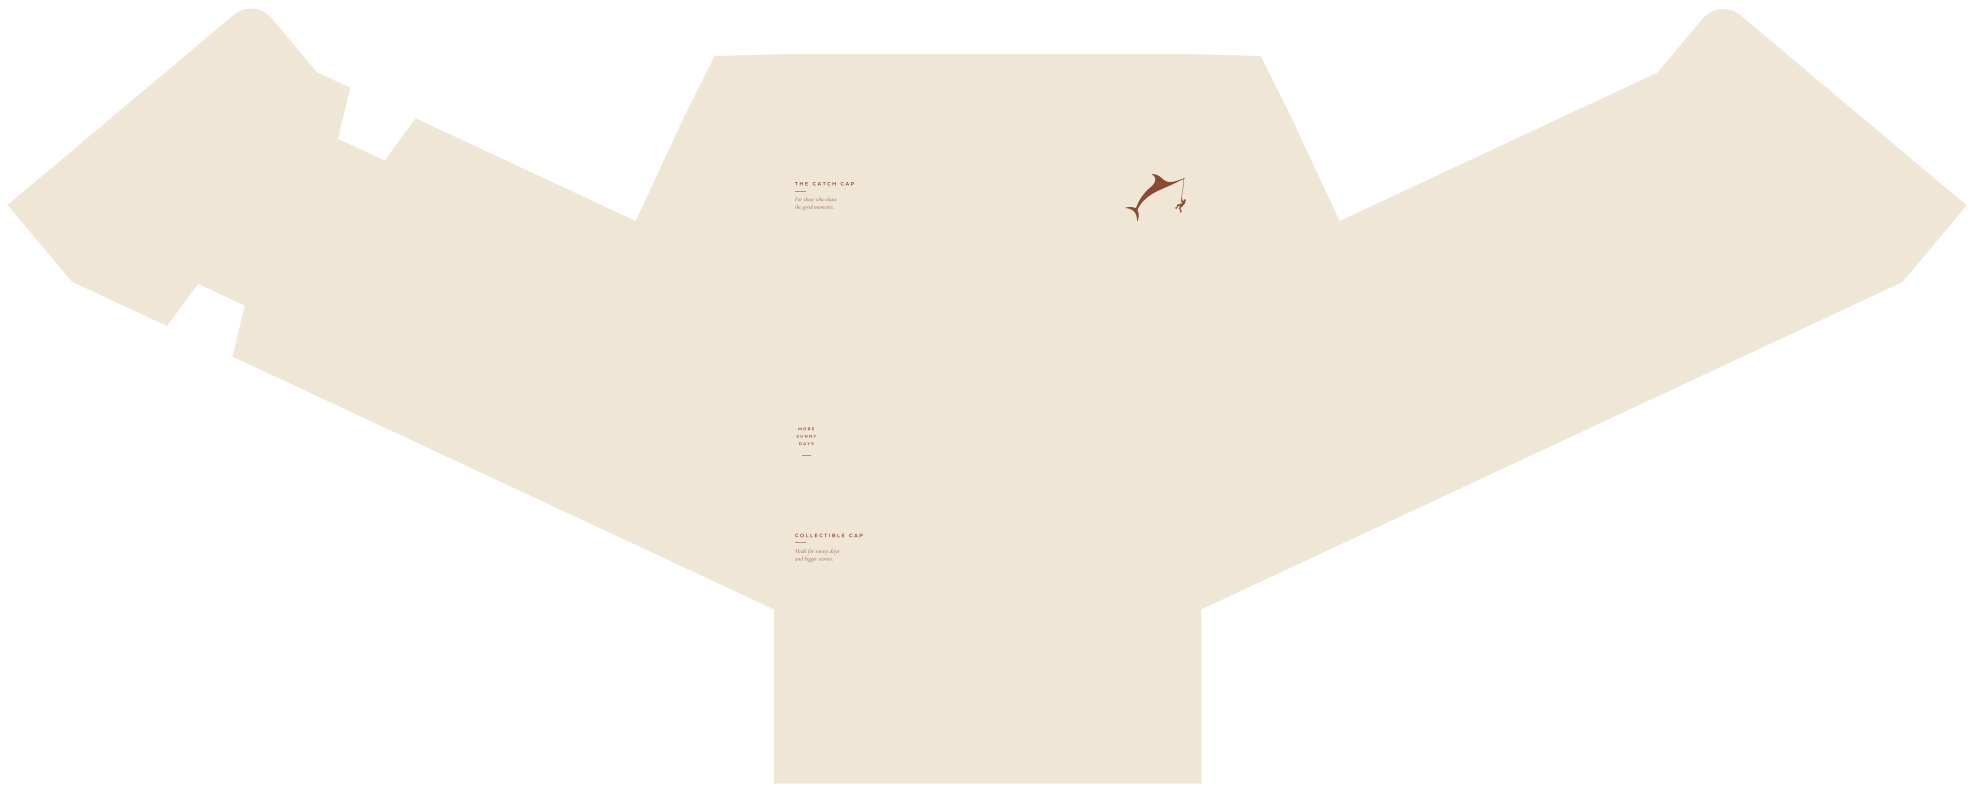
[picture p49: page 1]
