Tymur771/bank-transactions-site/(commit log)

2025-04-09 стейтманты
2026-11-09 Add MFC cap box 3D assembly viewer and print design templates
    Interactive three.js viewer that folds the Rev H box and Rev C insert
    step by step from geometry extracted from the source PDFs, plus layered
    SVG/PDF artwork templates (cut, crease, safe, bleed, orientation guides)
    and a draft concept design.
    Claude-Session: https://claude.ai/code/session_01LqDBXMSNu8NKCgt1mwQyAE
2026-11-09 Add box Rev I: step at the back of the side split so the base hides the insert
    Base side wall keeps full height (196 mm) for 60 mm from the back wall,
    then slopes 44.6 deg to the unchanged front point. Side liners, lid sides,
    lid liners and lid ears are recomputed; outside dimensions unchanged.
    Adds the Rev I die-line drawing (SVG/PDF), design template, and a
    Rev I / Rev H switch in the 3D viewer.
    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
2026-11-09 Add factory production package for box Rev I and insert Rev C
    1:1 die-line PDFs with CutContour/Crease spot colours and CUT/CREASE/INFO
    layers, DXF die-lines (mm), dimensioned drawings and an English
    production spec, zipped for sending to the factory.
    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
    [MFC-box-RevI_DIELINE.dxf, MFC-insert-RevC_DIELINE.dxf]
2026-11-09 Trim factory package to four English-only files
    Box Rev I and insert Rev C: one PRO 1:1 die-line PDF (spot colours,
    layers) and one dimensioned drawing each. DXF and spec sheet are now
    optional build flags.
    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
    [MFC-box-RevI_DIELINE.dxf, MFC-insert-RevC_DIELINE.dxf]
2026-11-09 Include DXF die-lines in the factory package and zip it
    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
    [MFC-box-RevI_dieline.dxf, MFC-insert-RevC_dieline.dxf]
2026-11-09 Design v1 from the mood shots, rounded folds and arch petal slider in 3D
    - Design v1: stone board, wide-tracked Montserrat caps paired with Cormorant
    Garamond italic, client logo silhouette; box outside, inside-of-lid
    (reverse print, mirrored print file) and insert artwork
    - 3D: fold bends swept from the board section (rounded doubled edges and
    corners instead of open flute), inside print toggle, arch petals on their
    own slider (0-30 deg inward) instead of folding in the assembly
    - Opens on the assembled box with the lid open; warmer studio light
    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
2026-11-09 Design v1.1 with bigger logo and a brand bottom, plus four new design directions
    - v1.1 (Stone): logo enlarged as the anchor outside and inside; bottom gets
    a round seal, monochrome US flag, 'Designed in California', icons and an
    edition number line
    - Design system in designs.py with variants Noir, Coastline, Big Mark and
    Sun-faded: print PDFs (outlined), editable SVGs and 3D snapshots each
    - PDFs rendered with Chromium so clip paths survive, cropped to the exact
    artboard; horizon line cut to panels geometrically
    - Gallery page comparing all directions
    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
2026-11-10 Box Rev J: lid hinges at the end of the step, fixed top with lock flaps
    The top is split by a crease 65.4 mm from the back, where the lid side
    starts, so the lid side turns about its own tip and stays on the base
    step when the lid opens (as in the rigid-box original). The fixed top
    over the step gets two side lock flaps that drop inside the side walls.
    Drawing, design files and the factory package regenerated for Rev J.
    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
    [MFC-box-RevI_dieline.dxf, MFC-box-RevJ_dieline.dxf]
2026-11-10 Box Rev K for the test print: clean corners and front
    - Fixed top at full outside width with a 180 hem on each side: the corner
    over the step is a smooth fold and the hem hides the side walls' raw top
    edges; the lock flap drops inside from the hem
    - Lid front 167.8 mm (was 161.7): stops 1 mm above the front lip; base
    diagonal ends behind the lip (26.4), so the open notch at the front
    corner is gone; lid side, lid liner and lid ear follow
    - Drawing dimension chain and side view derived from the panels
    - Factory package, design files and 3D regenerated for Rev K
    Claude-Session: https://claude.ai/code/session_01LqDBXMSNu8NKCgt1mwQ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
    [MFC-box-RevJ_dieline.dxf, MFC-box-RevK_dieline.dxf]
2026-11-10 Box Rev L: closing tongue on the base instead of a tuck on the lid
    The lid no longer carries a tuck flap. The inner lip lies on the front
    lip and has a 38 x 12 mm tongue rising through a widened thumb cut; the
    lid inner front hem forms a 1.8 mm pocket behind the lid front that
    slides down over the tongue on closing. Side-wall front ears go behind
    the inner lip; the assembly order changes accordingly. Creases are now
    drawn only where both panels have material. Factory package, drawing,
    design files and 3D regenerated for Rev L.
    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
    [MFC-box-RevK_dieline.dxf, MFC-box-RevL_dieline.dxf]
2026-11-11 Box Rev M: long closing tongue cut from the inner lip, plain front
    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
    [MFC-box-RevL_dieline.dxf, MFC-box-RevM_dieline.dxf]
2026-11-11 Box Rev N: 3-layer front tongue (207/211 mm), thumb notch on the lid front
    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
    [MFC-box-RevM_dieline.dxf, MFC-box-RevN_dieline.dxf]
2026-11-11 Rev N drawing: correct tongue height above the front lip (~22.8 mm)
    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
2026-11-11 Viewer: tongue height note ~23 mm
    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
2026-11-11 Print package Rev N: die-lines + artwork in one zip
    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
2026-11-12 Viewer: add Rev E (folder 5) rebuilt from its own DXF
    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
    [MFC-box-RevE-glueless-Eflute.dxf]
2026-11-12 Images for the printer: Rev E closure, front design, fold line comparison
    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
2026-11-12 Printer images v2: white inside, Rev K (step + lid tuck) as the request, front view lid open
    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
2026-11-12 Front image without the PREMIUM CAP label (render-only switch)
    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
